lgv2018/Power-Supply/README.md

# Power-Supply
Power supply based on arduino
test on my laptop
