lgv2018/Power-Supply/schematic/PowerSupply-Om.xlsx

Sheet: Sheet1
Specifications
Max voltage [v] | 20.48
Current (Max) [A] | 2.048
Resistor (Sense) | 0.1
# of resistors | 1
Eq. resistance [Ω] | 0.10
Voltage drop [V] | 0.2048
OpAmp Gain | 10
Final volt | 2.048
power of resistor [w] | 0.042 |  |  |  |  | 741 | 24.1
Measurement |  | Op-Amp Offset (max) |  | 32768 | 256 |  | 11856
ADC bit | 15 | mV | uV
ADC Type | MCP3427 | 0.062 | 62.500 |  |  |  |  | 741 | 241 | 24.1
Vref | 2.048
Current measurement
current resolution [A]/bit | 6.25e-05
current resolution/bit [mA] | 0.062
Voltage measurement
Voltage resolution [v]/bit | 0.001
Voltage resolution/bit [mv] | 0.625
Control |  | Op-Amp Offset (max)
DAC bit | 12 | mV | uV
DAC Type | MCP4726 | 0.500 | 500.000
Vref (Internal) | 2.048
Vout/bit [mv] | 0.5
Current command
Set current resolution [mA]/bit | 0.5
Voltage command
Set voltage resolution [mv]/bit | 5

Sheet: Combined
Final qty | Value | Package | Device | Parts | Description | Source
2 | 6V/0.5A | 1206 | PPTC_HALF-AMP | F2 | Resettable Fuse PPTC | Available
11 |  | 1X02 | PINHD-1X2 | JP51, JP62 | PIN HEADER | Available
2 |  | 1X05 | PINHD-1X5 | ICSP | PIN HEADER | Available
2 |  | 1X06 | PINHD-1X6 | JTAG | PIN HEADER | Available
2 |  | 1X17 | PINHD-1X17 | JP1, JP2 | PIN HEADER | Available
2 |  | 1X20 | PINHD-1X20 | JP1, JP2 | PIN HEADER | Available
2 |  | 2X04 | PINHD-2X4 | JP2, JP3 | PIN HEADER | Available
1 |  | 2X05 | PINHD-2X5 | JP1 | PIN HEADER | Available
1 | 93LC46 | 93LC46 | SOIC8 | IC2 |  | LCSC
2 | AUDIO_JACK_TRRSSMD_RA | AUDIO_JACK_3.5MM_TRRS_SMD_RA | AUDIO_JACK_TRRSSMD_RA | AUDIO | Audio Jack - 3.5mm TRRS (SMD) | LCSC
129 | 100nf | C0603 | C-EUC0603 | C1, C2, C3, C5, C8, C9, C12, C13, C14, C16, C18, C19, C21, C23, C24, C28, C29, C30, C34, C36, C37, C38, C39, C44, C45, C46, C47, C48, C52, C57, C58, C59, C60, C61, C62, C63, C64, C65, C66, C68, C71, C74, C76, C79, C84, C86, C90, C91 | CAPACITOR, European symbol | LCSC
6 | 22pf | C0603 | CAPC603 | C12, C13 |  | LCSC | To
61 | 100nf | C0805 | C-EUC0805 | C4, C22 | CAPACITOR, European symbol | LCSC
50 | 100pf | C0805 | C-EUC0805 | C41, C42, C43, C44, C45, C46, C47, C48, C49, C50 | CAPACITOR, European symbol | LCSC
51 | 10nf | C0805 | C-EUC0805 | C21, C22, C23, C24, C25, C26, C27, C28, C29, C30 | CAPACITOR, European symbol | LCSC
4 | 10pf | C0805 | C-EUC0805 | C69, C70 | CAPACITOR, European symbol | Available
2 | 10uf | C0805 | C-EUC0805 | C67 | CAPACITOR, European symbol | LCSC
2 | 15nf | C0805 | C-EUC0805 | C17 | CAPACITOR, European symbol | LCSC
57 | 1nf | C0805 | C-EUC0805 | C31, C32, C33, C34, C35, C36, C37, C38, C39, C40 | CAPACITOR, European symbol | LCSC
12 | 2.2uf | C0805 | C-EUC0805 | C10, C11, C77, C78 | CAPACITOR, European symbol | LCSC
2 | 2.7n | C0805 | C-EUC0805 | C43 | CAPACITOR, European symbol | LCSC
4 | 22pf | C0805 | C-EUC0805 | C55, C56 | CAPACITOR, European symbol | Available
16 | 4.7n | C0805 | C-EUC0805 | C6, C7, C25, C41, C42, C49, C50, C51 | CAPACITOR, European symbol | Available
2 | 4.7uf | C0805 | C-USC0805 | C16, C17 | CAPACITOR, American symbol | LCSC
1 | 470pf | C0805 | C-USC0805 | C7 | CAPACITOR, American symbol | Available
50 | 1uf | C1206 | C-EUC1206 | C1, C2, C3, C4, C5, C6, C7, C8, C9, C10 | CAPACITOR, European symbol | LCSC
4 | 3.3uf | C1206 | C-EUC1206 | C88, C89 | CAPACITOR, European symbol | LCSC
6 | 10uf | C1210 | C-EUC1210 | C83, C85, C87 | CAPACITOR, European symbol | Available
3 | 1uF | C603 | CAPC603 | C7, C8, C9 |  | LCSC
3 | 4.7uF | CAP_POLSMC_A | SMC_A | C11, C12, C22 |  | LCSC
27 | Green | CHIP-LED0805 | LEDCHIP-LED0805 | STAT | LED | Available
4 | CON-USB-MINI-BUSB1 | CONN_USB_MINI-B | CON-USB-MINI-BUSB1 | J1 | USB connector | LCSC
2 | 32.768kHz | CRYSTAL-PTH-2X6-CYL | CRYSTAL-32.768KHZPTH-2X6 | Y3 | 32.768kHz Crystal | Available
2 | 25Mhz | CRYSTAL-SMD-3.2X2.5MM | CRYSTALSMD-3.2X2.5 | Y2 | Crystals (Generic) | Available
1 | 5MHz | CRYSTAL-SMD-5X3.2-4PAD | CRYSTALSMD-5X3.2-4PAD | Y1 | Crystals (Generic) | LCSC
2 | 47uf 25V | CT6032 | CPOL-EUCT6032 | C32 | POLARIZED CAPACITOR, European symbol | Available
6 | 1k | CTS742C083 | CTS742C083 | RN1, RN2, RN3, RN4, RN5, RN6 | Chip Resistor Array 4 Single Resistor | LCSC
2 | SMAJ13A | DO214AC | SMAJ13ASMA403A | D2 | DIODE | LCSC
2 | LM317MABDT | DPACK | LM317MABDT | IC2 | 500 mA Adjustable Output Positive Voltage Regulator | LCSC
8 | 10uf 16V | E2-5 | CPOL-EUE2-5 | C15, C20, C31 | POLARIZED CAPACITOR, European symbol | Available
10 | 47uf 16V | E2-5 | CPOL-EUE2-5 | C53, C54, C80, C81, C82 | POLARIZED CAPACITOR, European symbol | Available
6 | 47uf 25V | E2-5 | CPOL-EUE2-5 | C33, C35, C40 | POLARIZED CAPACITOR, European symbol | Available
2 | 220uf 25v | E3,5-8 | CPOL-EUE3.5-8 | C26 | POLARIZED CAPACITOR, European symbol | Available
2 | 22uf 25v | E3,5-8 | CPOL-EUE3.5-8 | C27 | POLARIZED CAPACITOR, European symbol | Available
4 | EL357 | EL357 | EL357 | U$4, U$27 |  | LCSC
2 |  | FERRITE_BEAD603 | FB603 | L1, L2 |  | Available
1 | FT2232H | FT2232H | LQFP64 | IC1 | DUAL HIGH SPEED USB TO MULTIPURPOSE UART/FIFO IC | Arrow
2 | 2A | FUSE | FUSE | F1 | FUSE | Available
3 | 12MHz | HC49/S | CRYSTALHC49S | Q1 | CRYSTAL | LCSC
1 | 10mH | INDUCTOR_L0805 | INDUCTOR/FERRITE-BEAD0805 | L1 |  | Available
1 | 1mH | INDUCTOR_L0805 | INDUCTOR/FERRITE-BEAD0805 | L2 |  | Available
1 |  | JP1EJP | 1X02 | JP4 | JUMPER | Available
350 |  | JP2 | JP2 | JP52, JP53, JP54, JP55, JP56, JP57, JP58, JP59, JP60, JP61, JP63, JP64, JP65, JP66, JP67, JP68, JP69, JP70, JP71, JP72, JP73, JP74, JP75, JP76, JP77, JP78, JP79, JP80, JP81, JP82, JP83, JP84, JP85, JP86, JP87, JP88, JP89, JP90, JP91, JP92, JP93, JP94, JP95, JP96, JP97, JP98, JP99, JP100, JP101, JP102, JP103, JP104, JP105, JP106, JP107, JP108, JP109, JP110, JP111, JP112, JP113, JP114, JP115, JP116, JP117, JP118, JP119, JP120, JP121, JP122 | JUMPER | Available
255 |  | JP2@1 | JP2E | JP1, JP2, JP3, JP4, JP5, JP6, JP7, JP8, JP9, JP10, JP11, JP12, JP13, JP14, JP15, JP16, JP17, JP18, JP19, JP20, JP21, JP22, JP23, JP24, JP25, JP26, JP27, JP28, JP29, JP30, JP31, JP32, JP33, JP34, JP35, JP36, JP37, JP38, JP39, JP40, JP41, JP42, JP43, JP44, JP45, JP46, JP47, JP48, JP49, JP50, JP123 | JUMPER | Available
1 | LD1117-3.3 | LD1117-3.3 | SOT223 | IC3 |  | Available
2 | STM32F427VIT6 | LQFP100 | STM32F427VIT6 | U$28 | STM32F405RGT6 | Available
1 | TMS320F28027PTTHCTSMD | LQFP-48 | TMS320F28027PTTHCTSMD | IC3 |  | Available
2 | MICROSD-9P | MICRO-SD9+4P-SMD-16.1X14.5X1.85MM | MICRO-SD-CARD-HOLDER-9P | J3 | 320090008 | LCSC
10 | MKDSN1,5/2-5,08 | MKDSN1,5/2-5,08 | MKDSN1,5/2-5,08 | X1, X3 | MKDSN 1,5/ 2-5,08 Printklemme | Available
1 | OSC-OSCILLATOR | OSCILLATOR_7X5_SMD | OSC-OSCILLATOR | Q1 | Oscillator | Available
1 | P8X32A | P8X32A-Q44_MCU | P8X32A-Q44 | U1 | Propellor uC | Arrow
1 |  | PINHD-1X6 | 1X06 | JP1 | PIN HEADER | Available
1 |  | PINHD-1X9 | 1X09 | JP2 | PIN HEADER | Available
1 |  | PINHEAD_-_COPY_PINHD-2X10SHROUDED | PINHEAD_-_COPY_PINSHRD_PTH_2X10 | JTAG | PIN HEADER | Available
1 | HEADER2X5-SHRD-PTH-B | PINSHRD_PTH_2X05B | HEADER2X5-SHRD-PTH-B | IO | Shrouded pin header, 2.54mm pitch | Available
2 | POWER_JACK | POWER_JACK_PTH | POWER_JACK | J2 | Power Jack Connector | Available
2 | MCP23008QFN20 | QFN20 | MCP23008QFN20 | IC16 | MCP23008 | Arrow
2 | 0R | R0402 | R-EU_R0402 | R76 | RESISTOR, European symbol | Available
4 | 1.8k 0.1% | R0603 | R-US_R0603 | R29, R31 | RESISTOR, American symbol | LCSC
10 | 0R | R0805 | R-US_R0805 | R17, R30, R45, R46, R70 | RESISTOR, American symbol | Available
2 | 1.5k | R0805 | R-US_R0805 | R63 | RESISTOR, American symbol | Available
48 | 100k | R0805 | R-US_R0805 | R62 | RESISTOR, American symbol | LCSC
4 | 100R | R0805 | R-US_R0805 | R18, R19 | RESISTOR, American symbol | Available
89 | 10k | R0805 | R-US_R0805 | R11, R49, R51, R52, R53, R54, R56, R60, R61, R67, R68, R69, R71, R72, R73, R75, R78, R82, R83 | RESISTOR, American symbol | LCSC
4 | 10R | R0805 | R-US_R0805 | R22, R23 | RESISTOR, American symbol | Available
1 | 18k | R0805 | R-US_R0805 | R9 | RESISTOR, American symbol | Available
6 | 18k 0.1% | R0805 | R-US_R0805 | R13, R26, R28 | RESISTOR, American symbol | Available
20 | 1k | R0805 | R-US_R0805 | R39, R42, R43, R65 | RESISTOR, American symbol | Available
4 | 1k 0.1% | R0805 | R-US_R0805 | R14, R86 | RESISTOR, American symbol | Available
45 | 1M | R0805 | R-US_R0805 | R1, R2, R3, R4, R5, R6, R7, R8, R9 | RESISTOR, American symbol | LCSC
16 | 2.2k | R0805 | R-US_R0805 | R2, R5, R9, R21, R24, R32, R37 | RESISTOR, American symbol | Available
2 | 20k | R0805 | R-US_R0805 | R74 | RESISTOR, American symbol | Available
6 | 20R | R0805 | R-US_R0805 | R57, R58, R79 | RESISTOR, American symbol | Available
6 | 220R | R0805 | R-US_R0805 | R20, R25, R33 | RESISTOR, American symbol | Available
2 | 240R | R0805 | R-US_R0805 | R15 | RESISTOR, American symbol | Available
8 | 250R | R0805 | R-US_R0805 | R47, R59, R84, R85 | RESISTOR, American symbol | Available
1 | 270R | R0805 | R-US_R0805 | R5 | RESISTOR, American symbol | Available
7 | 2K | R0805 | R-US_R0805 | R1, R5 | RESISTOR, American symbol | Available
2 | 330R | R0805 | R-US_R0805 | R10 | RESISTOR, American symbol | Available
2 | 400R | R0805 | R-US_R0805 | R41 | RESISTOR, American symbol | Available
7 | 470R | R0805 | R-US_R0805 | R4, R80, R81 | RESISTOR, American symbol | Available
6 | 500R | R0805 | R-US_R0805 | R55 | RESISTOR, American symbol | Available
4 | 50R | R0805 | R-US_R0805 | R16, R44 | RESISTOR, American symbol | Available
1 | 5k | R0805 | R-US_R0805 | R2 | RESISTOR, American symbol | Available
18 | 6.8k | R0805 | R-US_R0805 | R3, R6, R7, R8, R35, R36, R40, R64, R66 | RESISTOR, American symbol | Available
4 | 680R | R0805 | R-US_R0805 | R1, R27 | RESISTOR, American symbol | Available
1 | 8.2k | R0805 | R-US_R0805 | R10 | RESISTOR, American symbol | Available
2 | 9k | R0805 | R-US_R0805 | R38 | RESISTOR, American symbol | LCSC
2 | NC | R0805 | R-US_R0805 | R34 | RESISTOR, American symbol | Available
45 | 1R | R1206 | R-US_R1206 | R55, R56, R57, R58, R59, R60, R61, R62, R63 | RESISTOR, American symbol | LCSC
45 | 100R | R1210 | R-US_R1210 | R37, R38, R39, R40, R41, R42, R43, R44, R45 | RESISTOR, American symbol | LCSC
45 | 10R | R1210 | R-US_R1210 | R46, R47, R48, R49, R50, R51, R52, R53, R54 | RESISTOR, American symbol | LCSC
45 | 1k | R1210 | R-US_R1210 | R28, R29, R30, R31, R32, R33, R34, R35, R36 | RESISTOR, American symbol | LCSC
2 | 0R100 | R2512 | R-EU_R2512 | R12 | RESISTOR, European symbol | Available
1 | 100R | RESISTORR1206 | R1206 | R8 |  | Available
4 | 10k | RN8P-4R-CRA06S | RNETWORK | RN1, RN2, RN3 | 4 Resistor Array 0603 | Available
1 | 12K | R-US_R0805 | R0805 | R1 | RESISTOR, American symbol | Available
9 | 82R | R-US_R0805 | R0805 | R3, R4, R5, R7, R9, R13, R14, R15, R16 | RESISTOR, American symbol | Available
2 | S1M | SMA | S1M | D1 |  | Available
4 | 10uF | SMC_A | CPOL-EUSMCA | C10, C11 | POLARIZED CAPACITOR, European symbol | LCSC
5 | 3.3uF | SMC_A | CAP_POLSMC_A | C5, C6, C7, C9 |  | LCSC
2 | CH340G | SO016 | CH340GSMD | U1 | A simple USB 2.0 to Serial IC. | Available
1 | 24LC256 | SO08 | EEPROM-I2CSMD | U2 | I2C EEPROMs, 24LC256 and others | LCSC
4 | LM358D | SO08 | LM358D | IC14, IC19 | OP AMP also LM158; LM258; LM2904 | Available
2 | OPA2196 | SO08 | LM358D | IC1 | OP AMP also LM158; LM258; LM2904 | Available
4 | OPA2197 | SO08 | LM358D | IC3 | OP AMP also LM158; LM258; LM2904 | Available
2 | W25Q32 | SO08 | SPI_FLASH-X25XXSMD | U1 | 32M Serial Flash Memory | LCSC
2 | ISO1541D | SO-08 | ISO1541D | IC11 |  | Available
2 | MCP1501-20E/SN | SO-08 | MCP1501-20E/SN | IC5 |  | Available
4 | 744053S | SO16 | 744053S | IC12, IC13 | Triple 2-channel analog multiplexer/demultiplexer | LCSC
1 | AD8655R | SO8 | AD8655R | IC2 | Low Noise, Precision CMOS Amplifier | Arrow
3 | REG1117 | SOT223 | REG1117 | IC18 | 800mA and 1A Low Dropout (LDO) Positive Regulator | Available
2 | V_REG_317SMD | SOT223 | V_REG_317SMD | IC8 | Voltage Regulator | LCSC
2 | 2N7002 | SOT23 | MOSFET-NCHANNELBSS138 | Q2 | Common NMOSFET Parts | LCSC
8 | BAS40-04 | SOT23 | BAS40-04 | D3, D4, D7, D8 | Silicon Schottky Diodes | LCSC
2 | BC847 | SOT23 | BC847 | T2 | NPN TRANSISTOR | LCSC
5 | FDN340P | SOT-23 | SMD-MOSFET-P-CH-20V-2A-FDN340P(SOT-23) | Q3 | 305030026 | LCSC
1 | AP2204K-3.3TRG1 | SOT-23-5 | AP2204K-3.3TRG1 | U3 | 150ma Low-Noise LDO Regulator | LCSC
2 | ME6206A33P1G | SOT-23-5 | MIC5205 | VR1, VR2 | 150ma Low-Noise LDO Regulator | LCSC
1 | NCP114ASN180T1G | SOT-23-5 | NCP114ASN180T1G | U2 | 150ma Low-Noise LDO Regulator | LCSC
1 | TJ5205SF5-5.0 | SOT-23-5 | MIC5205 | VR3 | 150ma Low-Noise LDO Regulator | LCSC
4 | MCP4726 | SOT23-6 | MCP4726 | IC6, IC7 |  | Available
2 | USBLC6-2P | SOT23-6 | USBLC6-2P | D5 |  | LCSC
4 | MMBT2222A | SOT23-BEC | MMBT2222ALT1-NPN-SOT23-BEC | T3, T4 | NPN Transistror | Available
1 | MMBT3904 | SOT23-BEC | MMBT3904LT1-NPN-SOT23-BEC | T1 | NPN Transistror | Available
2 | PMBT3906 | SOT23-BEC | MMBT3906LT1-PNP-SOT23-BEC | T1 | PNP Transistror | Available
1 | ME6206A33P1G | SOT89 | ME6206A33P1G | IC1 |  | LCSC
4 | L79L05SOT89 | SOT89 | L79L05SOT89 | U$22, U$24 |  | LCSC
1 | PIC24FJ64GA002 | SSOP28 | PIC24FJ64GA002 | IC1 | 16-bit General Purpose Flash Microcontroller | Arrow
1 |  | SW-SMD-SMALL | TACT_SWITCH_SMALL | PB |  | Available
1 | SMD button small | TACT_SWITCH_SMALL | SMD_TACT_SMALL | PB |  | Available
7 | SWITCH-SWITCH-SMD-3.0X4.0X2.0MM | TACTILE_SWITCH_SMD_6.0X3.5MM | SWITCH-SWITCH-SMD-3.0X4.0X2.0MM | K15, RST, WK_UP |  | Available
1 | MOMENTARY-SWITCH-SPST-SMD-6.2MM-TALL | TACTILE_SWITCH_SMD_6.2MM_TALL | MOMENTARY-SWITCH-SPST-SMD-6.2MM-TALL | S1 | Momentary Switch (Pushbutton) - SPST | Available
2 | TIP147 | TO220AV | TIP42C | Q4 | PNP TRANSISTOR | LCSC
2 | 7805DT | TO252 | 7805DT | IC17 | Positive VOLTAGE REGULATOR | LCSC
2 | MCP9700 | TO92-BCE | MCP9700 | U$20 |  | Available
2 | CS4344 | TSSOP10 | CS4344 | U$29 |  | LCSC
1 | 4066 | TSSOP14 | 4066 | IC3 | Quad bilateral ANALOG SWITCH | LCSC
2 | MCP3428TSSOP | TSSOP14 | MCP3428TSSOP | IC15 |  | Available
3 | TXS0108 | TSSOP20-0.65-6.5X4.4MM | LOGIC-TXS0108EPWR(TSSOP20) | U3, U4, U5 | 310050026 | LCSC
2 | USB-FS | USB-MINIB | USBMINIB | USB | USB Connectors | LCSC
1 | 700mA+ ferrite | WE-KI_0805_B | WE-KIL_0805 | L1 | SMD Wire Wound Ceramic Inductor WE-KIL | Available
6 | SRV05-4-N | WE-TVS_SOT23-6L | WE-TVS_SOT23-6L_HS_824015 | D1, D2, D3, D4, D5, D6 | WE-TVS TVS Diode – High Speed Series | LCSC
2 | XC2C32A_VQ44_2 | XC2C32A_VQ44_2 | VQ44 | IC4 | xc2c32a_vq44-ian edit this description | Aliexpress
1 | 3.6V Zener | ZENERSOD-123 | SOD-123 | D1 | Zener Diode SOD-323 | LCSC

Sheet: Sheet9
LCSC Part Number | Manufacture Part Number | Manufacturer | Package | Description | RoHS | Order Qty. | Min\Mult Order Qty. | Unit Price | Order Price | Product Link
C282732 | TCC0805X7R104K500DT | CCTC | 0805 | Multilayer Ceramic Capacitors MLCC - SMD/SMT 100nF 50V 0805 RoHS | yes | 500 | 50\50 | 0.0037 | 1.85 | https://lcsc.com/product-detail/Multilayer-Ceramic-Capacitors-MLCC-SMD-SMT_CCTC-TCC0805X7R104K500DT_C282732.html
C307531 | CL21A226MQQNNNF | Samsung Electro-Mechanics | 0805 | Multilayer Ceramic Capacitors MLCC - SMD/SMT 22uF 6.3V 0805 RoHS | yes | 20 | 20\20 | 0.0219 | 0.438 | https://lcsc.com/product-detail/Others_Samsung-Electro-Mechanics_CL21A226MQQNNNF_Samsung-Electro-Mechanics-CL21A226MQQNNNF_C307531.html
C15850 | CL21A106KAYNNNE | Samsung Electro-Mechanics | 0805 | Multilayer Ceramic Capacitors MLCC - SMD/SMT 10uF 25V 0805 RoHS | yes | 40 | 20\20 | 0.0188 | 0.752 | https://lcsc.com/product-detail/Multilayer-Ceramic-Capacitors-MLCC-SMD-SMT_SAMSUNG_CL21A106KAYNNNE_10uF-106-10-25V_C15850.html
C49217 | 0805F225M500NT | Guangdong Fenghua Advanced Tech | 0805 | Multilayer Ceramic Capacitors MLCC - SMD/SMT 2.2uF 50V 0805 RoHS | yes | 20 | 20\20 | 0.0318 | 0.636 | https://lcsc.com/product-detail/Multilayer-Ceramic-Capacitors-MLCC-SMD-SMT_2-2uF-225-20-50V_C49217.html
C108453 | MM1Z3B3 | Semtech | SOD-123 | Zener Diodes SOD-123 RoHS | yes | 20 | 20\20 | 0.0168 | 0.336 | https://lcsc.com/product-detail/Zener-Diodes_MM1Z3B3_C108453.html
C113174 | MM1Z4B7 | Semtech | SOD-123 | Zener Diodes SOD-123 RoHS | yes | 20 | 20\20 | 0.016 | 0.32 | https://lcsc.com/product-detail/Zener-Diodes_MM1Z4B7_C113174.html
C118717 | MM1Z5248B | Semtech | SOD-123 | Zener Diodes SOD-123 RoHS | yes | 20 | 20\20 | 0.0223 | 0.446 | https://lcsc.com/product-detail/Zener-Diodes_MM1Z5248B_C118717.html
C309876 | SMAJ22CA | Brightking Elec (TAIWAN) | SMA(DO-214AC) | TVS SMA(DO-214AC) RoHS | yes | 10 | 10\10 | 0.0636 | 0.636 | https://lcsc.com/product-detail/Others_Brightking-Elec-TAIWAN-SMAJ22CA_C309876.html
C78265 | BAS40-04LT1G | ON Semicon | SOT-23(SOT-23-3) | Schottky Barrier Diodes (SBD) SOT-23(SOT-23-3) RoHS | yes | 20 | 20\20 | 0.0293 | 0.586 | https://lcsc.com/product-detail/Schottky-Barrier-Diodes-SBD_ON-Semicon_BAS40-04LT1G_ON-Semicon-ON-BAS40-04LT1G_C78265.html
C85047 | 2N7002K-7 | Diodes Incorporated | SOT-23(SOT-23-3) | MOSFET N Trench 60V 380mA 2.5V @ 1mA 2 Ω @ 500mA，10V SOT-23(SOT-23-3) RoHS | yes | 20 | 20\20 | 0.0276 | 0.552 | https://lcsc.com/product-detail/MOSFET_Diodes-Incorporated_2N7002K-7_Diodes-Incorporated-2N7002K-7_C85047.html
C5647 | 74HC4053D,653 | Nexperia | SOIC-16_150mil | 74 Series SOIC-16_150mil RoHS | yes | 5 | 1\1 | 0.1559 | 0.7795 | https://lcsc.com/product-detail/74-Series_NXP_74HC4053D_74HC4053D_C5647.html
C19651 | LM317G-AA3-R | Unisonic Tech | SOT-223 | Linear Voltage Regulators SOT-223 RoHS | yes | 5 | 5\5 | 0.1056 | 0.528 | https://lcsc.com/product-detail/Linear-Voltage-Regulators_LM317G-AA3-R_C19651.html
C384446 | WF12P1R00FTL | Walsin Tech Corp | 1206 | Chip Resistor - Surface Mount 1Ohms ±1% 1/2W 1206 RoHS | yes | 50 | 50\50 | 0.0085 | 0.425 | https://lcsc.com/product-detail/New-Arrivals_Walsin-Tech-Corp-WF12P1R00FTL_C384446.html
C83141 | RC1210FR-0710RL | YAGEO | 1210 | Chip Resistor - Surface Mount 10Ohms ±1% 1/2W 1210 RoHS | yes | 50 | 20\20 | 0.0175 | 0.875 | https://lcsc.com/product-detail/Chip-Resistor-Surface-Mount_10R-10R0-1_C83141.html
C104955 | RTT121000FTP | RALEC | 1210 | Chip Resistor - Surface Mount 100Ohms ±1% 1/2W 1210 RoHS | yes | 50 | 50\50 | 0.0098 | 0.49 | https://lcsc.com/product-detail/Chip-Resistor-Surface-Mount_100R-1000-1_C104955.html
C104956 | RTT121001FTP | RALEC | 1210 | Chip Resistor - Surface Mount 1KOhms ±1% 1/2W 1210 RoHS | yes | 50 | 50\50 | 0.0094 | 0.47 | https://lcsc.com/product-detail/Chip-Resistor-Surface-Mount_1KR-1001-1_C104956.html
C276216 | RK73H2ATTD1003F | KOA Speer Elec | 0805 | Chip Resistor - Surface Mount 100KOhms ±1% 1/4W 0805 RoHS | yes | 100 | 50\50 | 0.0046 | 0.46 | https://lcsc.com/product-detail/Others_KOA-Speer-Elec-RK73H2ATTD1003F_C276216.html
C116837 | 0805B104J101 | Walsin Tech Corp | 0805 | Multilayer Ceramic Capacitors MLCC - SMD/SMT 100nF 100V 0805 RoHS | yes | 60 | 20\20 | 0.0203 | 1.218 | https://lcsc.com/product-detail/Multilayer-Ceramic-Capacitors-MLCC-SMD-SMT_100nF-104-5-100V_C116837.html
C77483 | 0805N102J101 | Walsin Tech Corp | 0805 | Multilayer Ceramic Capacitors MLCC - SMD/SMT 1nF 100V 0805 RoHS | yes | 50 | 50\50 | 0.0111 | 0.555 | https://lcsc.com/product-detail/High-Voltage-Capacitors_1nF-102-5-100V_C77483.html
C296072 | 0805B103J101CT | Walsin Tech Corp | 0805 | Multilayer Ceramic Capacitors MLCC - SMD/SMT 10nF 100V 0805 RoHS | yes | 60 | 20\20 | 0.0191 | 1.146 | https://lcsc.com/product-detail/Others_Huaxin-S-T-0805B103J101CT_C296072.html
C7519 | USBLC6-2SC6 | STMicroelectronics | SOT-23-6 | Diodes - ESD SOT-23-6 RoHS | yes | 5 | 5\5 | 0.0883 | 0.4415 | https://lcsc.com/product-detail/Diodes-ESD_STMicroelectronics_USBLC6-2SC6_USBLC6-2SC6_C7519.html
C82344 | W25Q32JVSSIQ | Winbond Elec | SOIC-8_208mil | FLASH FLASH 32Mb (4M x 8) SPI - Dual/Quad I/O SOIC-8_208mil RoHS | yes | 3 | 1\1 | 0.2641 | 0.7923 | https://lcsc.com/product-detail/FLASH_Winbond-Elec-W25Q32JVSSIQ_C82344.html
C8952 | CS4344-CZZR | Cirrus Logic | TSSOP-10 | Digital To Analog Converters (DACs) 24 I2S 3.3 V,5 V TSSOP-10 RoHS | yes | 1 | 1\1 | 0.5027 | 0.5027 | https://lcsc.com/product-detail/Digital-To-Analog-Converters-DACs_Cirrus-Logic_CS4344-CZZ_CS4344-CZZ_C8952.html
C91145 | TF-01A | Korean Hroparts Elec | SMD | Connector - Card Sockets 8 1.1mm SMD RoHS | yes | 1 | 1\1 | 0.1973 | 0.1973 | https://lcsc.com/product-detail/Connector-Card-Sockets_Korean-Hroparts-Elec-TF-01A_C91145.html
C231644 | KAN0444-0201B/102 | GANGYUAN | SMD | Tactile Switches SPST-NO 4.00mm x 3.00mm 2.00mm 50mA @ 12VDC SMD RoHS | yes | 5 | 5\5 | 0.07 | 0.35 | https://lcsc.com/product-detail/Others_GANGYUAN-KAN0444-0201B-102_C231644.html
C319111 | PJ-320D-X | XKB Enterprise | SMD | Audio & Video Connectors Female SMD RoHS | yes | 1 | 1\1 | 0.1416 | 0.1416 | https://lcsc.com/product-detail/Audio-Video-Connectors_XKB-Enterprise-PJ-320D-X_C319111.html
C59782 | CL10B105KO8NNNC | Samsung Electro-Mechanics | 0603 | Multilayer Ceramic Capacitors MLCC - SMD/SMT 1uF 16V 0603 RoHS | yes | 50 | 50\50 | 0.0065 | 0.325 | https://lcsc.com/product-detail/Multilayer-Ceramic-Capacitors-MLCC-SMD-SMT_SAMSUNG_CL10B105KO8NNNC_1uF-105-10-16V_C59782.html
C75560 | PMV48XP,215 | Nexperia | SOT-23(SOT-23-3) | MOSFET P Trench 20V 3.5A 1.25V @ 250uA 55 mΩ @ 2.4A，4.5V SOT-23(SOT-23-3) RoHS | yes | 5 | 5\5 | 0.0865 | 0.4325 | https://lcsc.com/product-detail/MOSFET_Nexperia_PMV48XP-215_Nexperia-PMV48XP-215_C75560.html
C180952 | RU20P3B | Shenzhen ruichips Semicon | SOT-23(SOT-23-3) | MOSFET P Trench 20V 3A 1V @ 250uA 100 mΩ @ 3A，4.5V SOT-23(SOT-23-3) RoHS | yes | 20 | 20\20 | 0.0202 | 0.404 | https://lcsc.com/product-detail/MOSFET_Shenzhen-ruichips-Semicon-RU20P3B_C180952.html
C268590 | MMSZ5231A | PANJIT International | SOD-123 | Zener Diodes SOD-123 RoHS | yes | 20 | 20\20 | 0.0167 | 0.334 | https://lcsc.com/product-detail/New-Arrivals_PANJIT-International-MMSZ5231A_C268590.html
C282320 | MMSZ5251B_R1_00001 | PANJIT International | SOD-123 | Zener Diodes SOD-123 RoHS | yes | 20 | 20\20 | 0.0184 | 0.368 | https://lcsc.com/product-detail/Others_PANJIT-International-MMSZ5251B-R1-00001_C282320.html
C131846 | LBZT52C16T1G | Leshan Radio | SOD-123 | Zener Diodes SOD-123 RoHS | yes | 20 | 20\20 | 0.0184 | 0.368 | https://lcsc.com/product-detail/Zener-Diodes_LBZT52C16T1G_C131846.html
C2109 | BZT52C24 | Changjiang Electronics Tech (CJ) | SOD-123 | Zener Diodes SOD-123 RoHS | yes | 20 | 20\20 | 0.0185 | 0.37 | https://lcsc.com/product-detail/Zener-Diodes_Changjiang-Electronics-Tech-CJ-BZT52C24_C2109.html
C150094 | BC847CLT1G | ON Semicon | SOT-23(SOT-23-3) | Transistors (NPN/PNP) NPN 100mA 45V SOT-23(SOT-23-3) RoHS | yes | 20 | 20\20 | 0.0162 | 0.324 | https://lcsc.com/product-detail/Transistors-NPN-PNP_ON-Semicon_BC847CLT1G_ON-Semicon-ON-BC847CLT1G_C150094.html
C6649 | EL357N(B)(TA)-G | Everlight Elec | SOP-4_P2.54 | DIP Optocouplers SOP-4_P2.54 RoHS | yes | 5 | 5\5 | 0.0617 | 0.3085 | https://lcsc.com/product-detail/SMD-Optocouplers_EL357N-B-TA-G_C6649.html
C84047 | TIP147 | STMicroelectronics | TO-247 | Darlington Transistors 10A 100V TO-247 RoHS | yes | 2 | 1\1 | 0.9514 | 1.9028 | https://lcsc.com/product-detail/Others_STMicroelectronics_TIP147_STMicroelectronics-TIP147_C84047.html
C183890 | 78M12 | Guangdong Hottech | TO-252-2(DPAK) | Linear Voltage Regulators TO-252-2(DPAK) RoHS | yes | 5 | 5\5 | 0.0721 | 0.3605 | https://lcsc.com/product-detail/Linear-Voltage-Regulators_78M12_C183890.html
C5422 | CL21F105ZBFNNNE | Samsung Electro-Mechanics | 0805 | Multilayer Ceramic Capacitors MLCC - SMD/SMT 1uF 50V 0805 RoHS | yes | 50 | 50\50 | 0.013 | 0.65 | https://lcsc.com/product-detail/Multilayer-Ceramic-Capacitors-MLCC-SMD-SMT_SAMSUNG_CL21F105ZBFNNNE_1uF-105-80-20-50V_C5422.html
C296080 | 0805X335K250CT | Walsin Tech Corp | 0805 | Multilayer Ceramic Capacitors MLCC - SMD/SMT 3.3uF 25V 0805 RoHS | yes | 10 | 10\10 | 0.035 | 0.35 | https://lcsc.com/product-detail/Others_Huaxin-S-T-0805X335K250CT_C296080.html
C282825 | TCC1206X7R105M101HT | CCTC | 1206 | Multilayer Ceramic Capacitors MLCC - SMD/SMT 1uF 100V 1206 RoHS | yes | 60 | 20\20 | 0.028 | 1.68 | https://lcsc.com/product-detail/Multilayer-Ceramic-Capacitors-MLCC-SMD-SMT_CCTC-TCC1206X7R105M101HT_C282825.html
C107105 | CC0805JRNPO0BN101 | YAGEO | 0805 | Multilayer Ceramic Capacitors MLCC - SMD/SMT 100pF 100V 0805 RoHS | yes | 50 | 50\50 | 0.0093 | 0.465 | https://lcsc.com/product-detail/Multilayer-Ceramic-Capacitors-MLCC-SMD-SMT_100pF-101-5-100V_C107105.html
C228604 | AC0805FR-071ML | YAGEO | 0805 | Chip Resistor - Surface Mount 1MOhms ±1% 1/8W 0805 RoHS | yes | 50 | 100\100 | 0.0028 | 0.14 | https://lcsc.com/product-detail/Others_YAGEO-AC0805FR-071ML_C228604.html
C113194 | RM10FTN1002 | TA-I Tech | 0805 | Chip Resistor - Surface Mount 10KOhms ±1% 1/8W 0805 RoHS | yes | 50 | 50\50 | 0.0035 | 0.175 | https://lcsc.com/product-detail/Chip-Resistor-Surface-Mount_10KR-1002-1_C113194.html
C351669 | PTFR0603B1K80P9 | ResistorToday | 0603 | High Precision & Low TCR SMD Resistors 1.8KOhms ±0.1% 1/10W 0603 RoHS | yes | 5 | 5\5 | 0.0683 | 0.3415 | https://lcsc.com/product-detail/Others_ResistorToday-PTFR0603B1K80P9_C351669.html
C122849 | 79L05 | Shikues | SOT-89(SOT-89-3) | Linear Voltage Regulators SOT-89(SOT-89-3) RoHS | yes | 10 | 10\10 | 0.0594 | 0.594 | https://lcsc.com/product-detail/Linear-Voltage-Regulators_79L05_C122849.html
C18091 | 24LC512T-I/SM | Microchip Tech | SOIC-8_208mil | EEPROM EEPROM 512Kb (64K x 8) I2C SOIC-8_208mil RoHS | yes | 1 | 1\1 | 1.0707 | 1.0707 | https://lcsc.com/product-detail/EEPROM_MICROCHIP_24lc512T-I-SM_24lc512T-I-SM_C18091.html
C17206 | TXS0108EPWR | Texas Instruments | TSSOP-20 | Level Translators, Shifters TSSOP-20 RoHS | yes | 3 | 1\1 | 0.7191 | 2.1573 | https://lcsc.com/product-detail/Interface-ICs_TI_TXS0108EPWR_TXS0108EPWR_C17206.html
C20197 | 4D03WGJ0102T5E | Uniroyal Elec | 0603_x4 | Resistor Networks & Arrays 1KOhms ±5% 1/16W 0603_x4 RoHS | yes | 50 | 50\50 | 0.004 | 0.2 | https://lcsc.com/product-detail/Resistor-Networks-Arrays_Uniroyal-Elec-4D03WGJ0102T5E_C20197.html
C69074 | - | Jing Extension of the Electronic Co. | SMD | USB Connectors 5 Receptacle 1 SMD RoHS | yes | 10 | 10\10 | 0.0619 | 0.619 | https://lcsc.com/product-detail/USB-Connectors_Jing-Extension-of-the-Electronic-Co-LCSC-MINI-5PMotherboard-Copper-shell-with-column-LCPVinyl-High-temperature_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
C2198 | X49SD5MSD2SC | Yangxing Tech | HC-49S | 49S 5MHz ±20ppm HC-49S RoHS | yes | 5 | 5\5 | 0.0859 | 0.4295 | https://lcsc.com/product-detail/49S_Yangxing-Tech-X49SD5MSD2SC_C2198.html
C5628 | 74HC4066D,653 | Nexperia | SOIC-14_150mil | 74 Series SOIC-14_150mil RoHS | yes | 3 | 1\1 | 0.1591 | 0.4773 | https://lcsc.com/product-detail/74-Series_NXP_74HC4066D_74HC4066D_C5628.html
C126091 | TJ5205SF5-5.0 | HTC Korea TAEJIN Tech | SOT-23-5 | Low Dropout Regulators(LDO) Positive Fixed 350mV @ 150mA 16V 5V 150mA SOT-23-5 RoHS | yes | 1 | 1\1 | 0.1511 | 0.1511 | https://lcsc.com/product-detail/Low-Dropout-Regulators-LDO_HTC_TJ5205SF5-5-0_TJ5205SF5-5-0_C126091.html
C112032 | AP2204K-3.3TRG1 | Diodes Incorporated | SOT-23-5 | Low Dropout Regulators(LDO) Positive Fixed 500mV @ 150mA 24V 3.3V 200mA SOT-23-5 RoHS | yes | 2 | 1\1 | 0.1082 | 0.2164 | https://lcsc.com/product-detail/Low-Dropout-Regulators-LDO_DIODES_AP2204K-3-3TRG1_AP2204K-3-3TRG1_C112032.html
C16253 | 93LC46BT-I/SN | Microchip Tech | SOIC-8_150mil | EEPROM EEPROM 1Kb (64 x 16) SPI SOIC-8_150mil RoHS | yes | 1 | 1\1 | 0.1861 | 0.1861 | https://lcsc.com/product-detail/EEPROM_MICROCHIP_93LC46BT-I-SN_93LC46BT-I-SN_C16253.html
C127674 | HC-49S12MHz20pF30PPM | Zhejiang Abel Elec | HC-49S | 49S 12MHz ±30ppm HC-49S RoHS | yes | 5 | 5\5 | 0.0636 | 0.318 | https://lcsc.com/product-detail/49S_HC-49S-12MHz-20pF-30PPM_C127674.html
C126074 | LM79L05 | HTC Korea TAEJIN Tech | TO-92(TO-92-3) | Linear Voltage Regulators TO-92(TO-92-3) RoHS | yes | 5 | 5\5 | 0.0628 | 0.314 | https://lcsc.com/product-detail/Linear-Voltage-Regulators_HTC_LM79L05_LM79L05_C126074.html
C236700 | ME6206A33P1G | Nanjing Micro One Elec | SOT-89(SOT-89-3) | Linear Voltage Regulators SOT-89(SOT-89-3) RoHS | yes | 10 | 10\10 | 0.0582 | 0.582 | https://lcsc.com/product-detail/Others_Nanjing-Micro-One-Elec-ME6206A33P1G_C236700.html
C233362 | NCP114ASN180T1G | ON Semicon | TSOP-5 | Linear Voltage Regulators TSOP-5 RoHS | yes | 5 | 5\5 | 0.0852 | 0.426 | https://lcsc.com/product-detail/Linear-Voltage-Regulators_ON-Semicon_NCP114ASN180T1G_ON-Semicon-ON-NCP114ASN180T1G_C233362.html
C7184 | TAJA335K016RNJ | AVX | CASE-A_3216 | Tantalum Capacitors 3.3uF 16V CASE-A_3216 RoHS | yes | 5 | 5\5 | 0.0702 | 0.351 | https://lcsc.com/product-detail/Tantalum-Capacitors_AVX_TAJA335K016RNJ_3-3uF-335-10-16V_C7184.html
C376774 | TCC0603COG200J500CT | CCTC | 0603 | Multilayer Ceramic Capacitors MLCC - SMD/SMT 20pF 50V 0603 RoHS | yes | 50 | 50\50 | 0.0032 | 0.16 | https://lcsc.com/product-detail/New-Arrivals_CCTC-TCC0603COG200J500CT_C376774.html
C119052 | CA45-A010K106T | Hunan Xiangyee in S&T | CASE-A_3216 | Tantalum Capacitors 10uF 10V CASE-A_3216 RoHS | yes | 10 | 10\10 | 0.0634 | 0.634 | https://lcsc.com/product-detail/Tantalum-Capacitors_Hunan-Xiangyee-in-S-T-CA45-A010K106T_C119052.html
C106219 | CC0603ZRY5V7BB105 | YAGEO | 0603 | Multilayer Ceramic Capacitors MLCC - SMD/SMT 1uF 16V 0603 RoHS | yes | 50 | 50\50 | 0.0052 | 0.26 | https://lcsc.com/product-detail/Multilayer-Ceramic-Capacitors-MLCC-SMD-SMT_1uF-105-20-to-80-16V_C106219.html
C123256 | CA45-A016K475T | Hunan Xiangyee in S&T | CASE-A_3216 | Tantalum Capacitors 4.7uF 16V CASE-A_3216 RoHS | yes | 5 | 5\5 | 0.0627 | 0.3135 | https://lcsc.com/product-detail/Tantalum-Capacitors_Hunan-Xiangyee-in-S-T-CA45-A016K475T_C123256.html
C131753 | LMSZ5227BT1G | Leshan Radio | SOD-123 | Zener Diodes SOD-123 RoHS | yes | 20 | 20\20 | 0.017 | 0.34 | https://lcsc.com/product-detail/Zener-Diodes_LMSZ5227BT1G_C131753.html
C105478 | 1206X106K160NT | Guangdong Fenghua Advanced Tech | 1206 | Multilayer Ceramic Capacitors MLCC - SMD/SMT 10uF 16V 1206 RoHS | yes | 10 | 10\10 | 0.0354 | 0.354 | https://lcsc.com/product-detail/Multilayer-Ceramic-Capacitors-MLCC-SMD-SMT_10uF-106-10-16V_C105478.html
C42998 | 0603F104M500NT | Guangdong Fenghua Advanced Tech | 0603 | Multilayer Ceramic Capacitors MLCC - SMD/SMT 100nF 50V 0603 RoHS | yes | 200 | 100\100 | 0.0026 | 0.52 | https://lcsc.com/product-detail/Multilayer-Ceramic-Capacitors-MLCC-SMD-SMT_100nF-104-20-50V_C42998.html
C107143 | CC0805KRX7R9BB153 | YAGEO | 0805 | Multilayer Ceramic Capacitors MLCC - SMD/SMT 15nF 50V 0805 RoHS | yes | 50 | 50\50 | 0.006 | 0.3 | https://lcsc.com/product-detail/Multilayer-Ceramic-Capacitors-MLCC-SMD-SMT_15nF-153-10-50V_C107143.html
C68136 | LM317MDT-TR | STMicroelectronics | TO-252-2(DPAK) | Linear Voltage Regulators TO-252-2(DPAK) RoHS | yes | 2 | 1\1 | 0.14 | 0.28 | https://lcsc.com/product-detail/Linear-Voltage-Regulators_STMicroelectronics_LM317MDT-TR_LM317MDT-TR_C68136.html
C100114 | - | Boom Precision Elec | SIP-2 | Shunts & Jumpers 2 2.54mm Female Through Hole SIP-2 RoHS | yes | 50 | 50\50 | 0.0054 | 0.27 | https://lcsc.com/product-detail/Shunts-Jumpers_Short-hood2-54mm-Top-seal-Closed-type_C100114.html

Sheet: Power Supply + STM32
Qty | Final qty | Value | Device | Package | Parts | Description | MF | MPN | OC_FARNELL | OC_NEWARK | PROD_ID | SF_ID | SPICEPREFIX | VALUE
1 | 2 | 6V/0.5A | PPTC_HALF-AMP | 1206 | F2 | Resettable Fuse PPTC |  |  |  |  | RES-08585 |  |  | 6V/0.5A
1 | 2 | AUDIO_JACK_TRRSSMD_RA | AUDIO_JACK_TRRSSMD_RA | AUDIO_JACK_3.5MM_TRRS_SMD_RA | AUDIO | Audio Jack - 3.5mm TRRS (SMD) |  |  |  |  | CONN-10676 | PRT-12639
48 | 96 | 100nf | C-EUC0603 | C0603 | C1, C2, C3, C5, C8, C9, C12, C13, C14, C16, C18, C19, C21, C23, C24, C28, C29, C30, C34, C36, C37, C38, C39, C44, C45, C46, C47, C48, C52, C57, C58, C59, C60, C61, C62, C63, C64, C65, C66, C68, C71, C74, C76, C79, C84, C86, C90, C91 | CAPACITOR, European symbol |  |  |  |  |  |  | C
2 | 4 | 100nf | C-EUC0805 | C0805 | C4, C22 | CAPACITOR, European symbol |  |  |  |  |  |  | C
2 | 4 | 10pf | C-EUC0805 | C0805 | C69, C70 | CAPACITOR, European symbol |  |  |  |  |  |  | C
1 | 2 | 10uf | C-EUC0805 | C0805 | C67 | CAPACITOR, European symbol |  |  |  |  |  |  | C
1 | 2 | 15nf | C-EUC0805 | C0805 | C17 | CAPACITOR, European symbol |  |  |  |  |  |  | C
3 | 6 | 1uf | C-EUC0805 | C0805 | C72, C73, C75 | CAPACITOR, European symbol |  |  |  |  |  |  | C
4 | 8 | 2.2uf | C-EUC0805 | C0805 | C10, C11, C77, C78 | CAPACITOR, European symbol |  |  |  |  |  |  | C
1 | 2 | 2.7n | C-EUC0805 | C0805 | C43 | CAPACITOR, European symbol |  |  |  |  |  |  | C
2 | 4 | 22pf | C-EUC0805 | C0805 | C55, C56 | CAPACITOR, European symbol |  |  |  |  |  |  | C
8 | 16 | 4.7n | C-EUC0805 | C0805 | C6, C7, C25, C41, C42, C49, C50, C51 | CAPACITOR, European symbol |  |  |  |  |  |  | C
2 | 4 | 3.3uf | C-EUC1206 | C1206 | C88, C89 | CAPACITOR, European symbol |  |  |  |  |  |  | C
3 | 6 | 10uf | C-EUC1210 | C1210 | C83, C85, C87 | CAPACITOR, European symbol |  |  |  |  |  |  | C
1 | 2 | LE0 | LEDCHIP-LED0805 | CHIP-LED0805 | LE0 | LED
4 | 8 | Red | LEDCHIP-LED0805 | CHIP-LED0805 | CC, CV, LED2, PWR | LED
1 | 2 | 32.768kHz | CRYSTAL-32.768KHZPTH-2X6 | CRYSTAL-PTH-2X6-CYL | Y3 | 32.768kHz Crystal |  |  |  |  | XTAL-10112 |  |  | 32.768kHz
1 | 2 | 12Mhz | CRYSTALSMD-3.2X2.5 | CRYSTAL-SMD-3.2X2.5MM | Y2 | Crystals (Generic)
1 | 2 | 47uf 25V | CPOL-EUCT6032 | CT6032 | C32 | POLARIZED CAPACITOR, European symbol |  |  |  |  |  |  | C
1 | 2 | SMAJ13A | SMAJ13ASMA403A | DO214AC | D2 | DIODE
1 | 2 | LM317MABDT | LM317MABDT | DPACK | IC2 | 500 mA Adjustable Output Positive Voltage Regulator
3 | 6 | 10uf 16V | CPOL-EUE2-5 | E2-5 | C15, C20, C31 | POLARIZED CAPACITOR, European symbol |  |  |  |  |  |  | C
5 | 10 | 47uf 16V | CPOL-EUE2-5 | E2-5 | C53, C54, C80, C81, C82 | POLARIZED CAPACITOR, European symbol |  |  |  |  |  |  | C
3 | 6 | 47uf 25V | CPOL-EUE2-5 | E2-5 | C33, C35, C40 | POLARIZED CAPACITOR, European symbol |  |  |  |  |  |  | C
1 | 2 | 220uf 25v | CPOL-EUE3.5-8 | E3,5-8 | C26 | POLARIZED CAPACITOR, European symbol |  |  |  |  |  |  | C
1 | 2 | 22uf 25v | CPOL-EUE3.5-8 | E3,5-8 | C27 | POLARIZED CAPACITOR, European symbol |  |  |  |  |  |  | C
2 | 4 | EL357 | EL357 | EL357 | U$4, U$27
1 | 2 | 2A | FUSE | FUSE | F1 | FUSE
1 | 2 | STM32F427VIT6 | STM32F427VIT6 | LQFP100 | U$28 | STM32F405RGT6
1 | 2 | MICROSD-9P | MICRO-SD-CARD-HOLDER-9P | MICRO-SD9+4P-SMD-16.1X14.5X1.85MM | J3 | 320090008 |  |  |  |  |  |  |  | MICROSD-9P
1 | 2 | POWER_JACK | POWER_JACK | POWER_JACK_PTH | J2 | Power Jack Connector |  |  |  |  | CONN-08197
1 | 2 | MCP23008QFN20 | MCP23008QFN20 | QFN20 | IC16 | MCP23008
1 | 2 | 0R | R-EU_R0402 | R0402 | R76 | RESISTOR, European symbol |  |  |  |  |  |  | R
1 | 2 | NP | R-EU_R0402 | R0402 | R77 | RESISTOR, European symbol |  |  |  |  |  |  | R
2 | 4 | 1.8k 0.1% | R-US_R0603 | R0603 | R29, R31 | RESISTOR, American symbol |  |  |  |  |  |  | R
5 | 10 | 0R | R-US_R0805 | R0805 | R17, R30, R45, R46, R70 | RESISTOR, American symbol |  |  |  |  |  |  | R
1 | 2 | 1.5k | R-US_R0805 | R0805 | R63 | RESISTOR, American symbol |  |  |  |  |  |  | R
2 | 4 | 100R | R-US_R0805 | R0805 | R18, R19 | RESISTOR, American symbol |  |  |  |  |  |  | R
1 | 2 | 100k | R-US_R0805 | R0805 | R62 | RESISTOR, American symbol |  |  |  |  |  |  | R
2 | 4 | 10R | R-US_R0805 | R0805 | R22, R23 | RESISTOR, American symbol |  |  |  |  |  |  | R
20 | 40 | 10k | R-US_R0805 | R0805 | R11, R49, R51, R52, R53, R54, R56, R60, R61, R67, R68, R69, R71, R72, R73, R75, R78, R82, R83, R85 | RESISTOR, American symbol |  |  |  |  |  |  | R
3 | 6 | 18k 0.1% | R-US_R0805 | R0805 | R13, R26, R28 | RESISTOR, American symbol |  |  |  |  |  |  | R
4 | 8 | 1k | R-US_R0805 | R0805 | R39, R42, R43, R65 | RESISTOR, American symbol |  |  |  |  |  |  | R
2 | 4 | 1k 0.1% | R-US_R0805 | R0805 | R14, R86 | RESISTOR, American symbol |  |  |  |  |  |  | R
7 | 14 | 2.2k | R-US_R0805 | R0805 | R2, R5, R9, R21, R24, R32, R37 | RESISTOR, American symbol |  |  |  |  |  |  | R
3 | 6 | 20R | R-US_R0805 | R0805 | R57, R58, R79 | RESISTOR, American symbol |  |  |  |  |  |  | R
1 | 2 | 20k | R-US_R0805 | R0805 | R74 | RESISTOR, American symbol |  |  |  |  |  |  | R
3 | 6 | 220R | R-US_R0805 | R0805 | R20, R25, R33 | RESISTOR, American symbol |  |  |  |  |  |  | R
2 | 4 | 250R | R-US_R0805 | R0805 | R59, R15 | RESISTOR, American symbol |  |  |  |  |  |  | R
1 | 2 | 330R | R-US_R0805 | R0805 | R10 | RESISTOR, American symbol |  |  |  |  |  |  | R
6 | 12 | 470R | R-US_R0805 | R0805 | R4, R80, R81, R47, R84, R41 | RESISTOR, American symbol |  |  |  |  |  |  | R
1 | 2 | 500R | R-US_R0805 | R0805 | R55 | RESISTOR, American symbol |  |  |  |  |  |  | R
2 | 4 | 50R | R-US_R0805 | R0805 | R16, R44 | RESISTOR, American symbol |  |  |  |  |  |  | R
2 | 4 | 510R | R-US_R0805 | R0805 | R48, R50 | RESISTOR, American symbol |  |  |  |  |  |  | R
9 | 18 | 6.8k | R-US_R0805 | R0805 | R3, R6, R7, R8, R35, R36, R40, R64, R66 | RESISTOR, American symbol |  |  |  |  |  |  | R
2 | 4 | 680R | R-US_R0805 | R0805 | R1, R27 | RESISTOR, American symbol |  |  |  |  |  |  | R
1 | 2 | 9k | R-US_R0805 | R0805 | R38 | RESISTOR, American symbol |  |  |  |  |  |  | R
1 | 2 | NC | R-US_R0805 | R0805 | R34 | RESISTOR, American symbol |  |  |  |  |  |  | R
1 | 2 | 0R100 | R-EU_R2512 | R2512 | R12 | RESISTOR, European symbol |  |  |  |  |  |  | R
1 | 2 | S1M | S1M | SMA | D1
2 | 4 | LM358D | LM358D | SO08 | IC14, IC19 | OP AMP also LM158; LM258; LM2904
1 | 2 | OPA2196 | LM358D | SO08 | IC1 | OP AMP also LM158; LM258; LM2904
1 | 2 | OPA2197 | LM358D | SO08 | IC3 | OP AMP also LM158; LM258; LM2904
1 | 2 | OPA2197 | OPA2237U | SO08 | IC4 | Single-Supply Operational Amplifiers | TEXAS INSTRUMENTS | OPA2237UA | 1388075 | 80K6018
1 | 2 | W25Q32 | SPI_FLASH-X25XXSMD | SO08 | U1 | 32M Serial Flash Memory |  |  |  |  | N/A |  |  | 32M SPI Flash
1 | 2 | ISO1541D | ISO1541D | SO-08 | IC11
1 | 2 | MCP1501-20E/SN | MCP1501-20E/SN | SO-08 | IC5 |  |  |  |  |  |  |  | X
2 | 4 | 744053S | 744053S | SO16 | IC12, IC13 | Triple 2-channel analog multiplexer/demultiplexer
1 | 2 | REG1117 | REG1117 | SOT223 | IC18 | 800mA and 1A Low Dropout (LDO) Positive Regulator |  | REG1117 | 1097566 | 14P6981
1 | 2 | V_REG_317SMD | V_REG_317SMD | SOT223 | IC8 | Voltage Regulator
1 | 2 | 2N7002 | MOSFET-NCHANNELBSS138 | SOT23 | Q2 | Common NMOSFET Parts |  |  |  |  | TRANS-00830
4 | 8 | BAS40-04 | BAS40-04 | SOT23 | D3, D4, D7, D8 | Silicon Schottky Diodes
1 | 2 | BC847 | BC847 | SOT23 | T2 | NPN TRANSISTOR
1 | 2 | FDN340P | SMD-MOSFET-P-CH-20V-2A-FDN340P(SOT-23) | SOT-23 | Q3 | 305030026 |  | FDN340P |  |  |  |  |  | FDN340P
2 | 4 | MCP4726 | MCP4726 | SOT23-6 | IC6, IC7
1 | 2 | USBLC6-2P | USBLC6-2P | SOT23-6 | D5
2 | 4 | MMBT2222A | MMBT2222ALT1-NPN-SOT23-BEC | SOT23-BEC | T3, T4 | NPN Transistror
1 | 2 | PMBT3906 | MMBT3906LT1-PNP-SOT23-BEC | SOT23-BEC | T1 | PNP Transistror
2 | 4 | L79L05SOT89 | L79L05SOT89 | SOT89 | U$22, U$24
3 | 6 | SWITCH-SWITCH-SMD-3.0X4.0X2.0MM | SWITCH-SWITCH-SMD-3.0X4.0X2.0MM | TACTILE_SWITCH_SMD_6.0X3.5MM | K15, RST, WK_UP
1 | 2 | TIP147 | TIP42C | TO220AV | Q4 | PNP TRANSISTOR
1 | 2 | 7805DT | 7805DT | TO252 | IC17 | Positive VOLTAGE REGULATOR
1 | 2 | MCP9700 | MCP9700 | TO92-BCE | U$20
1 | 2 | TIP147 | TIP2955 | TOP3AV | Q1 | PNP TRANSISTOR
1 | 2 | CS4344 | CS4344 | TSSOP10 | U$29
1 | 2 | MCP3428TSSOP | MCP3428TSSOP | TSSOP14 | IC15
1 | 2 | USB-FS | USBMINIB | USB-MINIB | USB | USB Connectors

Sheet: Decade
Qty | Finalqty | Value | Device | Package | Parts | Description | SPICEPREFIX
70 | 350 |  | JP2 | JP2 | JP52, JP53, JP54, JP55, JP56, JP57, JP58, JP59, JP60, JP61, JP63, JP64, JP65, JP66, JP67, JP68, JP69, JP70, JP71, JP72, JP73, JP74, JP75, JP76, JP77, JP78, JP79, JP80, JP81, JP82, JP83, JP84, JP85, JP86, JP87, JP88, JP89, JP90, JP91, JP92, JP93, JP94, JP95, JP96, JP97, JP98, JP99, JP100, JP101, JP102, JP103, JP104, JP105, JP106, JP107, JP108, JP109, JP110, JP111, JP112, JP113, JP114, JP115, JP116, JP117, JP118, JP119, JP120, JP121, JP122 | JUMPER
51 | 255 |  | JP2E | JP2@1 | JP1, JP2, JP3, JP4, JP5, JP6, JP7, JP8, JP9, JP10, JP11, JP12, JP13, JP14, JP15, JP16, JP17, JP18, JP19, JP20, JP21, JP22, JP23, JP24, JP25, JP26, JP27, JP28, JP29, JP30, JP31, JP32, JP33, JP34, JP35, JP36, JP37, JP38, JP39, JP40, JP41, JP42, JP43, JP44, JP45, JP46, JP47, JP48, JP49, JP50, JP123 | JUMPER
2 | 10 |  | PINHD-1X2 | 1X02 | JP51, JP62 | PIN HEADER |  | R
1 | 5 | 1k | R-US_R0805 | R0805 | R64 | RESISTOR, American symbol | R | R
9 | 45 | 100R | R-US_R1210 | R1210 | R37, R38, R39, R40, R41, R42, R43, R44, R45 | RESISTOR, American symbol | R | C
9 | 45 | 100k | R-US_R0805 | R0805 | R10, R11, R12, R13, R14, R15, R16, R17, R18 | RESISTOR, American symbol | R | C
10 | 50 | 100nf | C-EUC0805 | C0805 | C11, C12, C13, C14, C15, C16, C17, C18, C19, C20 | CAPACITOR, European symbol | C | C
10 | 50 | 100pf | C-EUC0805 | C0805 | C41, C42, C43, C44, C45, C46, C47, C48, C49, C50 | CAPACITOR, European symbol | C | R
9 | 45 | 10R | R-US_R1210 | R1210 | R46, R47, R48, R49, R50, R51, R52, R53, R54 | RESISTOR, American symbol | R | C
9 | 45 | 10k | R-US_R0805 | R0805 | R19, R20, R21, R22, R23, R24, R25, R26, R27 | RESISTOR, American symbol | R | C
10 | 50 | 10nf | C-EUC0805 | C0805 | C21, C22, C23, C24, C25, C26, C27, C28, C29, C30 | CAPACITOR, European symbol | C
9 | 45 | 1M | R-US_R0805 | R0805 | R1, R2, R3, R4, R5, R6, R7, R8, R9 | RESISTOR, American symbol | R
9 | 45 | 1R | R-US_R1206 | R1206 | R55, R56, R57, R58, R59, R60, R61, R62, R63 | RESISTOR, American symbol | R
9 | 45 | 1k | R-US_R1210 | R1210 | R28, R29, R30, R31, R32, R33, R34, R35, R36 | RESISTOR, American symbol | R
10 | 50 | 1nf | C-EUC0805 | C0805 | C31, C32, C33, C34, C35, C36, C37, C38, C39, C40 | CAPACITOR, European symbol | C
10 | 50 | 1uf | C-EUC1206 | C1206 | C1, C2, C3, C4, C5, C6, C7, C8, C9, C10 | CAPACITOR, European symbol | C
2 | 10 | MKDSN1,5/2-5,08 | MKDSN1,5/2-5,08 | MKDSN1,5/2-5,08 | X1, X3 | MKDSN 1,5/ 2-5,08 Printklemme

Sheet: Busblaster
Qty | Value | Device | Package | Parts | Description | MF | MPN | OC_FARNELL | OC_NEWARK | SPICEPREFIX
1 |  | JP1EJP | 1X02 | JP4 | JUMPER
1 |  | PINHD-1X5 | 1X05 | JP3 | PIN HEADER
1 |  | PINHD-1X6 | 1X06 | JP1 | PIN HEADER
1 |  | PINHD-1X9 | 1X09 | JP2 | PIN HEADER
1 |  | PINHEAD_-_COPY_PINHD-2X10SHROUDED | PINHEAD_-_COPY_PINSHRD_PTH_2X10 | JTAG | PIN HEADER
1 | 100R | RESISTORR1206 | R1206 | R8
16 | 100nF | CAPC603 | C603 | C1, C2, C3, C4, C5, C6, C7, C13, C14, C15, C16, C17, C18, C19, C20, C21
1 | 10K | R-US_R0805 | R0805 | R12 | RESISTOR, American symbol |  |  |  |  | R
1 | 10k | RNETWORK | RN8P-4R-CRA06S | RN3 | 4 Resistor Array 0603
1 | 12K | R-US_R0805 | R0805 | R1 | RESISTOR, American symbol |  |  |  |  | R
1 | 12Mhz | CRYSTALHC49UP | HC49UP | Q1 | CRYSTAL |  |  | unknown | unknown
1 | 1K | R-US_R0805 | R0805 | R2 | RESISTOR, American symbol |  |  |  |  | R
1 | 2.2K | R-US_R0805 | R0805 | R6 | RESISTOR, American symbol |  |  |  |  | R
2 | 22pf | CAPC603 | C603 | C9, C10
2 | 2K | R-US_R0805 | R0805 | R10, R11 | RESISTOR, American symbol |  |  |  |  | R
1 | 3.3uF | CAP_POLSMC_A | SMC_A | C8
1 | 3.6V Zener | ZENERSOD-123 | SOD-123 | D1 | Zener Diode SOD-323
3 | 4.7uF | CAP_POLSMC_A | SMC_A | C11, C12, C22
9 | 82R | R-US_R0805 | R0805 | R3, R4, R5, R7, R9, R13, R14, R15, R16 | RESISTOR, American symbol |  |  |  |  | R
1 | 93C46 | 93C46 | SOIC8 | IC2
1 | CON-USB-MINI-BUSB1 | CON-USB-MINI-BUSB1 | CONN_USB_MINI-B | USB | USB connector
2 | FB | FERRITE_BEAD603 | FB603 | L1, L2
1 | FT2232H | FT2232H | LQFP64 | IC1 | DUAL HIGH SPEED USB TO MULTIPURPOSE UART/FIFO IC
1 | LD1117-3.3 | LD1117-3.3 | SOT223 | IC3
1 | Red | LED805 | LED-805 | LED
1 | Red | LEDCHIPLED_0805 | CHIPLED_0805 | PWR | LED
1 | Reset | SW-SMD-SMALL | TACT_SWITCH_SMALL | PB
1 | XC2C32A_VQ44_2 | XC2C32A_VQ44_2 | VQ44 | IC4 | xc2c32a_vq44-ian edit this description

Sheet: Bus Pirate
Qty | Value | Device | Package | Parts | Description | MF | MPN | OC_FARNELL | OC_NEWARK | PROD_ID | SPICEPREFIX
1 |  | PINHD-1X5 | 1X05 | ICSP | PIN HEADER
5 | 0.1uF | CAPC603 | C603 | C1, C2, C3, C4, C5
3 | 1uF | CAPC603 | C603 | C7, C8, C9
2 | 22pf | CAPC603 | C603 | C12, C13
8 |  | LEDCHIP-LED0805 | CHIP-LED0805 | LED1, LED1A, LED2, LED2A, LED3, LED3A, LED4, LED4A | LED
1 | CON-USB-MINI-BUSB1 | CON-USB-MINI-BUSB1 | CONN_USB_MINI-B | J1 | USB connector
1 | 12MHz | CRYSTALHC49S | HC49/S | Q1 | CRYSTAL |  |  | 1667008 | unknown
1 | LOGO_CC-0 | LOGO_CC-0 | LOGO_CC-0 | LOGO1
1 | HEADER2X5-SHRD-PTH-B | HEADER2X5-SHRD-PTH-B | PINSHRD_PTH_2X05B | IO | Shrouded pin header, 2.54mm pitch
4 | 1k | R-US_R0805 | R0805 | R2, R3, R4, R6 | RESISTOR, American symbol |  |  |  |  |  | R
2 | 2K | R-US_R0805 | R0805 | R1, R5 | RESISTOR, American symbol |  |  |  |  |  | R
3 | 10k | RNETWORK | RN8P-4R-CRA06S | RN1, RN2, RN3 | 4 Resistor Array 0603
2 | 10uF | CPOL-EUSMCA | SMC_A | C10, C11 | POLARIZED CAPACITOR, European symbol
1 | CH340G | CH340GSMD | SO016 | U1 | A simple USB 2.0 to Serial IC. |  |  |  |  | IC-13498
2 | ME6206A33P1G | MIC5205 | SOT-23-5 | VR1, VR2 | 150ma Low-Noise LDO Regulator
1 | PIC24FJ64GA002 | PIC24FJ64GA002 | SSOP28 | IC1 | 16-bit General Purpose Flash Microcontroller
1 | FDN340P | FDN340P | SUPER-SOT3 | Q2 | Single P-Channel, PowerTrench (R) MOSFET
1 | 4066 | 4066 | TSSOP14 | IC3 | Quad bilateral ANALOG SWITCH
1 | 700mA+ ferrite | WE-KIL_0805 | WE-KI_0805_B | L1 | SMD Wire Wound Ceramic Inductor WE-KIL
1 | TJ5205SF5-5.0 | MIC5205 | SOT-23-5 | VR3 | 150ma Low-Noise LDO Regulator

Sheet: CPLD
Qty | Value | Device | Package | Parts | Description | SPICEPREFIX
2 |  | PINHD-1X17 | 1X17 | JP1, JP2 | PIN HEADER
1 |  | PINHD-1X2 | 1X02 | JP3 | PIN HEADER
1 |  | PINHD-1X6 | 1X06 | JTAG | PIN HEADER
1 |  | SJ | SJ | SJ1 | SMD solder JUMPER
1 | AP2204K-3.3TRG1 | AP2204K-3.3TRG1 | SOT-23-5 | U3 | 150ma Low-Noise LDO Regulator
5 | 0.1uF | CAPC603 | C603 | C1, C2, C3, C4, C8
1 | 10K | R-US_R0805 | R0805 | R1 | RESISTOR, American symbol | R
3 | 2K | R-US_R0805 | R0805 | R2, R3, R4 | RESISTOR, American symbol | R
4 | 3.3uF | CAP_POLSMC_A | SMC_A | C5, C6, C7, C9
1 | NCP114ASN180T1G | NCP114ASN180T1G | SOT-23-5 | U2 | 150ma Low-Noise LDO Regulator
1 | OSC-OSCILLATOR | OSC-OSCILLATOR | OSCILLATOR_7X5_SMD | Q1 | Oscillator
1 | SMD button small | SMD_TACT_SMALL | TACT_SWITCH_SMALL | PB
1 | XC2C32A_VQ44_2 | XC2C32A_VQ44_2 | VQ44 | U1 | xc2c32a_vq44-ian edit this description
3 | Yellow LED | LED805 | LED-805 | D1, D2, PWR

Sheet: TMS320F23027
Qty | Value | Device | Package | Parts | Description | MF | MPN | OC_FARNELL | OC_NEWARK | PROD_ID | SPICEPREFIX | VALUE
2 |  | PINHD-1X20 | 1X20 | JP1, JP2 | PIN HEADER
1 | 0.1uf | C-USC0603 | C0603 | C8 | CAPACITOR, American symbol |  |  |  |  |  | C
4 | 2.2uf | C-USC0805 | C0805 | C1, C3, C4, C5 | CAPACITOR, American symbol |  |  |  |  |  | C
2 | 0.1uF | CAPC603 | C603 | C2, C6
2 | 22pf | CAPC603 | C603 | C12, C13
1 | RX(RED) | LEDCHIP-LED0805 | CHIP-LED0805 | RX | LED
1 | TX(Green) | LEDCHIP-LED0805 | CHIP-LED0805 | TX | LED
1 | CON-USB-MINI-BUSB1 | CON-USB-MINI-BUSB1 | CONN_USB_MINI-B | J1 | USB connector
1 | 12MHz | CRYSTALHC49S | HC49/S | Q1 | CRYSTAL |  |  | 1667008 | unknown
1 | 10mH | INDUCTOR/FERRITE-BEAD0805 | INDUCTOR_L0805 | L1
1 | 1mH | INDUCTOR/FERRITE-BEAD0805 | INDUCTOR_L0805 | L2
1 | TMS320F28027PTTHCTSMD | TMS320F28027PTTHCTSMD | LQFP-48 | IC3
1 | 2.2k | R-US_R0805 | R0805 | R1 | RESISTOR, American symbol |  |  |  |  |  | R
1 | 5k | R-US_R0805 | R0805 | R2 | RESISTOR, American symbol |  |  |  |  |  | R
2 | 1K | R-US_R0805 | R0805 | R3, R4
1 | 10uF | CPOL-EUSMCA | SMC_A | C10 | POLARIZED CAPACITOR, European symbol
1 | 10uf | CPOL-USSMCA | SMC_A | C9 | POLARIZED CAPACITOR, American symbol |  |  |  |  |  | C
1 | CH340G | CH340GSMD | SO016 | IC2 | A simple USB 2.0 to Serial IC. |  |  |  |  | IC-13498 |  | CH340G
1 | ME6206A33P1G | ME6206A33P1G | SOT89 | IC1
2 | FDN340P | FDN340P | SUPER-SOT3 | Q2, Q3 | Single P-Channel, PowerTrench (R) MOSFET
1 | SWITCH-SWITCH-SMD-3.0X4.0X2.0MM | SWITCH-SWITCH-SMD-3.0X4.0X2.0MM | TACTILE_SWITCH_SMD_6.0X3.5MM | RESET

Sheet: Jatagulator
Qty | Value | Device | Package | Parts | Description
1 |  | PINHD-1X6 | 1X06 | JP4 | PIN HEADER
2 |  | PINHD-2X4 | 2X04 | JP2, JP3 | PIN HEADER
1 |  | PINHD-2X5 | 2X05 | JP1 | PIN HEADER
1 | 0.01uf | C-USC0805 | C0805 | C5 | CAPACITOR, American symbol
4 | 0.1uf | C-USC0603 | C0603 | C18, C19, C20, C21 | CAPACITOR, American symbol
7 | 0.1uf | C-USC0805 | C0805 | C8, C10, C11, C12, C13, C14, C15 | CAPACITOR, American symbol
1 | 100k | R-US_R0805 | R0805 | R8 | RESISTOR, American symbol
4 | 10k | R-US_R0805 | R0805 | R2, R3, R6, R7 | RESISTOR, American symbol
2 | 10uf | CPOL-USE2.5-5 | E2,5-5 | C1, C9 | POLARIZED CAPACITOR, American symbol
1 | 18k | R-US_R0805 | R0805 | R9 | RESISTOR, American symbol
1 | 1nf | C-USC0805 | C0805 | C6 | CAPACITOR, American symbol
1 | 24LC256 | EEPROM-I2CSMD | SO08 | U2 | I2C EEPROMs, 24LC256 and others
1 | 270R | R-US_R0805 | R0805 | R5 | RESISTOR, American symbol
2 | 4.7uf | C-USC0805 | C0805 | C16, C17 | CAPACITOR, American symbol
1 | 470R | R-US_R0805 | R0805 | R4 | RESISTOR, American symbol
1 | 470pf | C-USC0805 | C0805 | C7 | CAPACITOR, American symbol
1 | 5MHz | CRYSTALSMD-5X3.2-4PAD | CRYSTAL-SMD-5X3.2-4PAD | Y1 | Crystals (Generic)
1 | 8.2k | R-US_R0805 | R0805 | R10 | RESISTOR, American symbol
1 | AD8655R | AD8655R | SO8 | IC2 | Low Noise, Precision CMOS Amplifier
6 | 1K | CTS742C083 | CTS742C083 | RN1, RN2, RN3, RN4, RN5, RN6 | Chip Resistor Array 4 Single Resistor
1 | Green | LEDCHIP-LED0805 | CHIP-LED0805 | STAT | LED
1 | MMBT3904 | MMBT3904LT1-NPN-SOT23-BEC | SOT23-BEC | T1 | NPN Transistror
1 | MOMENTARY-SWITCH-SPST-SMD-6.2MM-TALL | MOMENTARY-SWITCH-SPST-SMD-6.2MM-TALL | TACTILE_SWITCH_SMD_6.2MM_TALL | S1 | Momentary Switch (Pushbutton) - SPST
1 | P8X32A | P8X32A-Q44 | P8X32A-Q44_MCU | U1 | Propellor uC
1 | REG1117 | REG1117 | SOT223 | IC3 | 800mA and 1A Low Dropout (LDO) Positive Regulator
1 | Red | LEDCHIP-LED0805 | CHIP-LED0805 | LED4 | LED
6 | SRV05-4-N | WE-TVS_SOT23-6L_HS_824015 | WE-TVS_SOT23-6L | D1, D2, D3, D4, D5, D6 | WE-TVS TVS Diode – High Speed Series
3 | TXS0108 | LOGIC-TXS0108EPWR(TSSOP20) | TSSOP20-0.65-6.5X4.4MM | U3, U4, U5 | 310050026
