lgv2018/Power-Supply/schematic/Powersupply_RevA_discrete.pdf

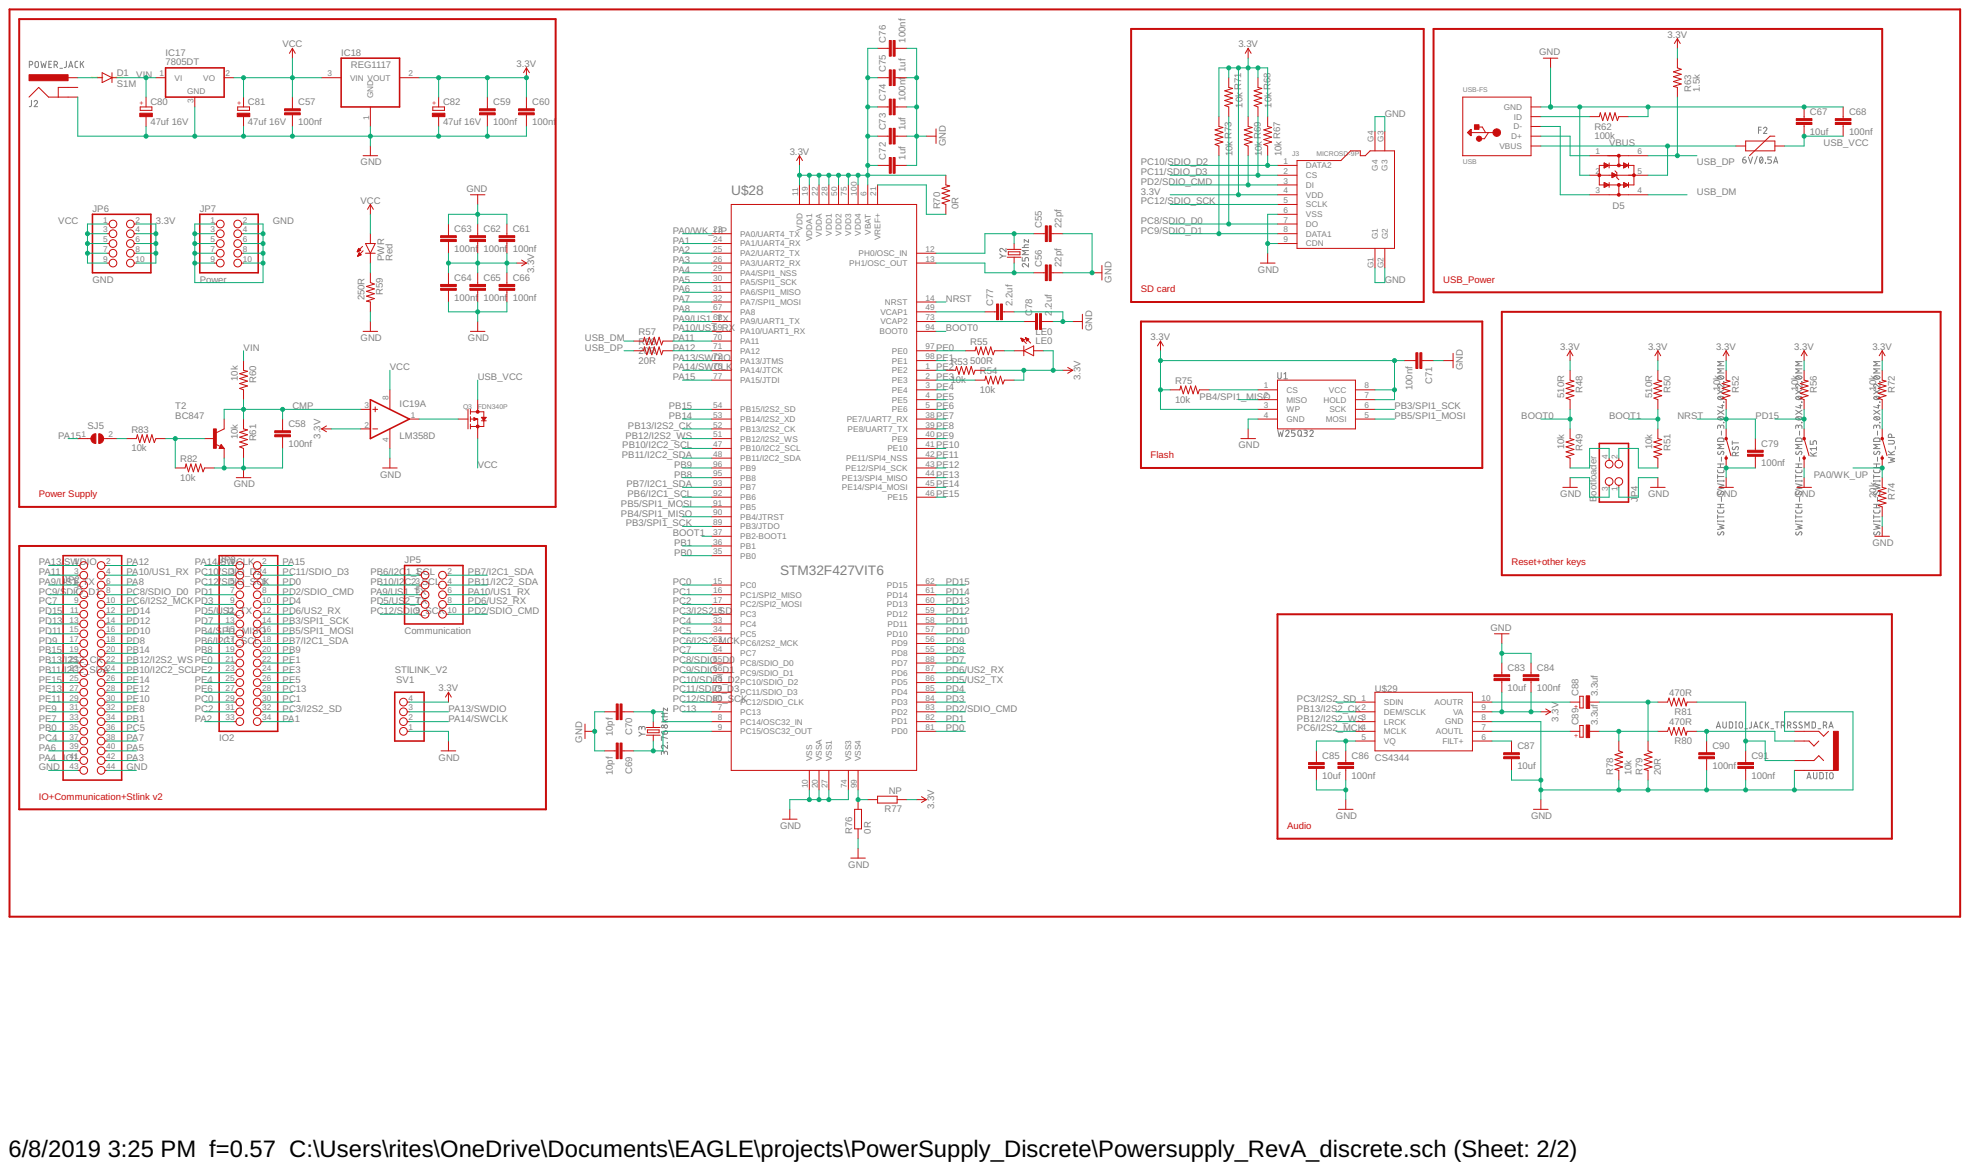
[picture p1: page 1]

GND

38 PE8/UART7_TX PE7 | Flash

6/8/2019 3:25 PM f=0.57 C:\Users\rites\OneDrive\Documents\EAGLE\projects\PowerSupply_Discrete\Powersupply_RevA_discrete.sch (Sheet: 2/2)
