lgv2018/Power-Supply/schematic/Powersupply_RevA_discrete.brd

## EAGLE design schematic/Powersupply_RevA_discrete.brd (2019-09-19)

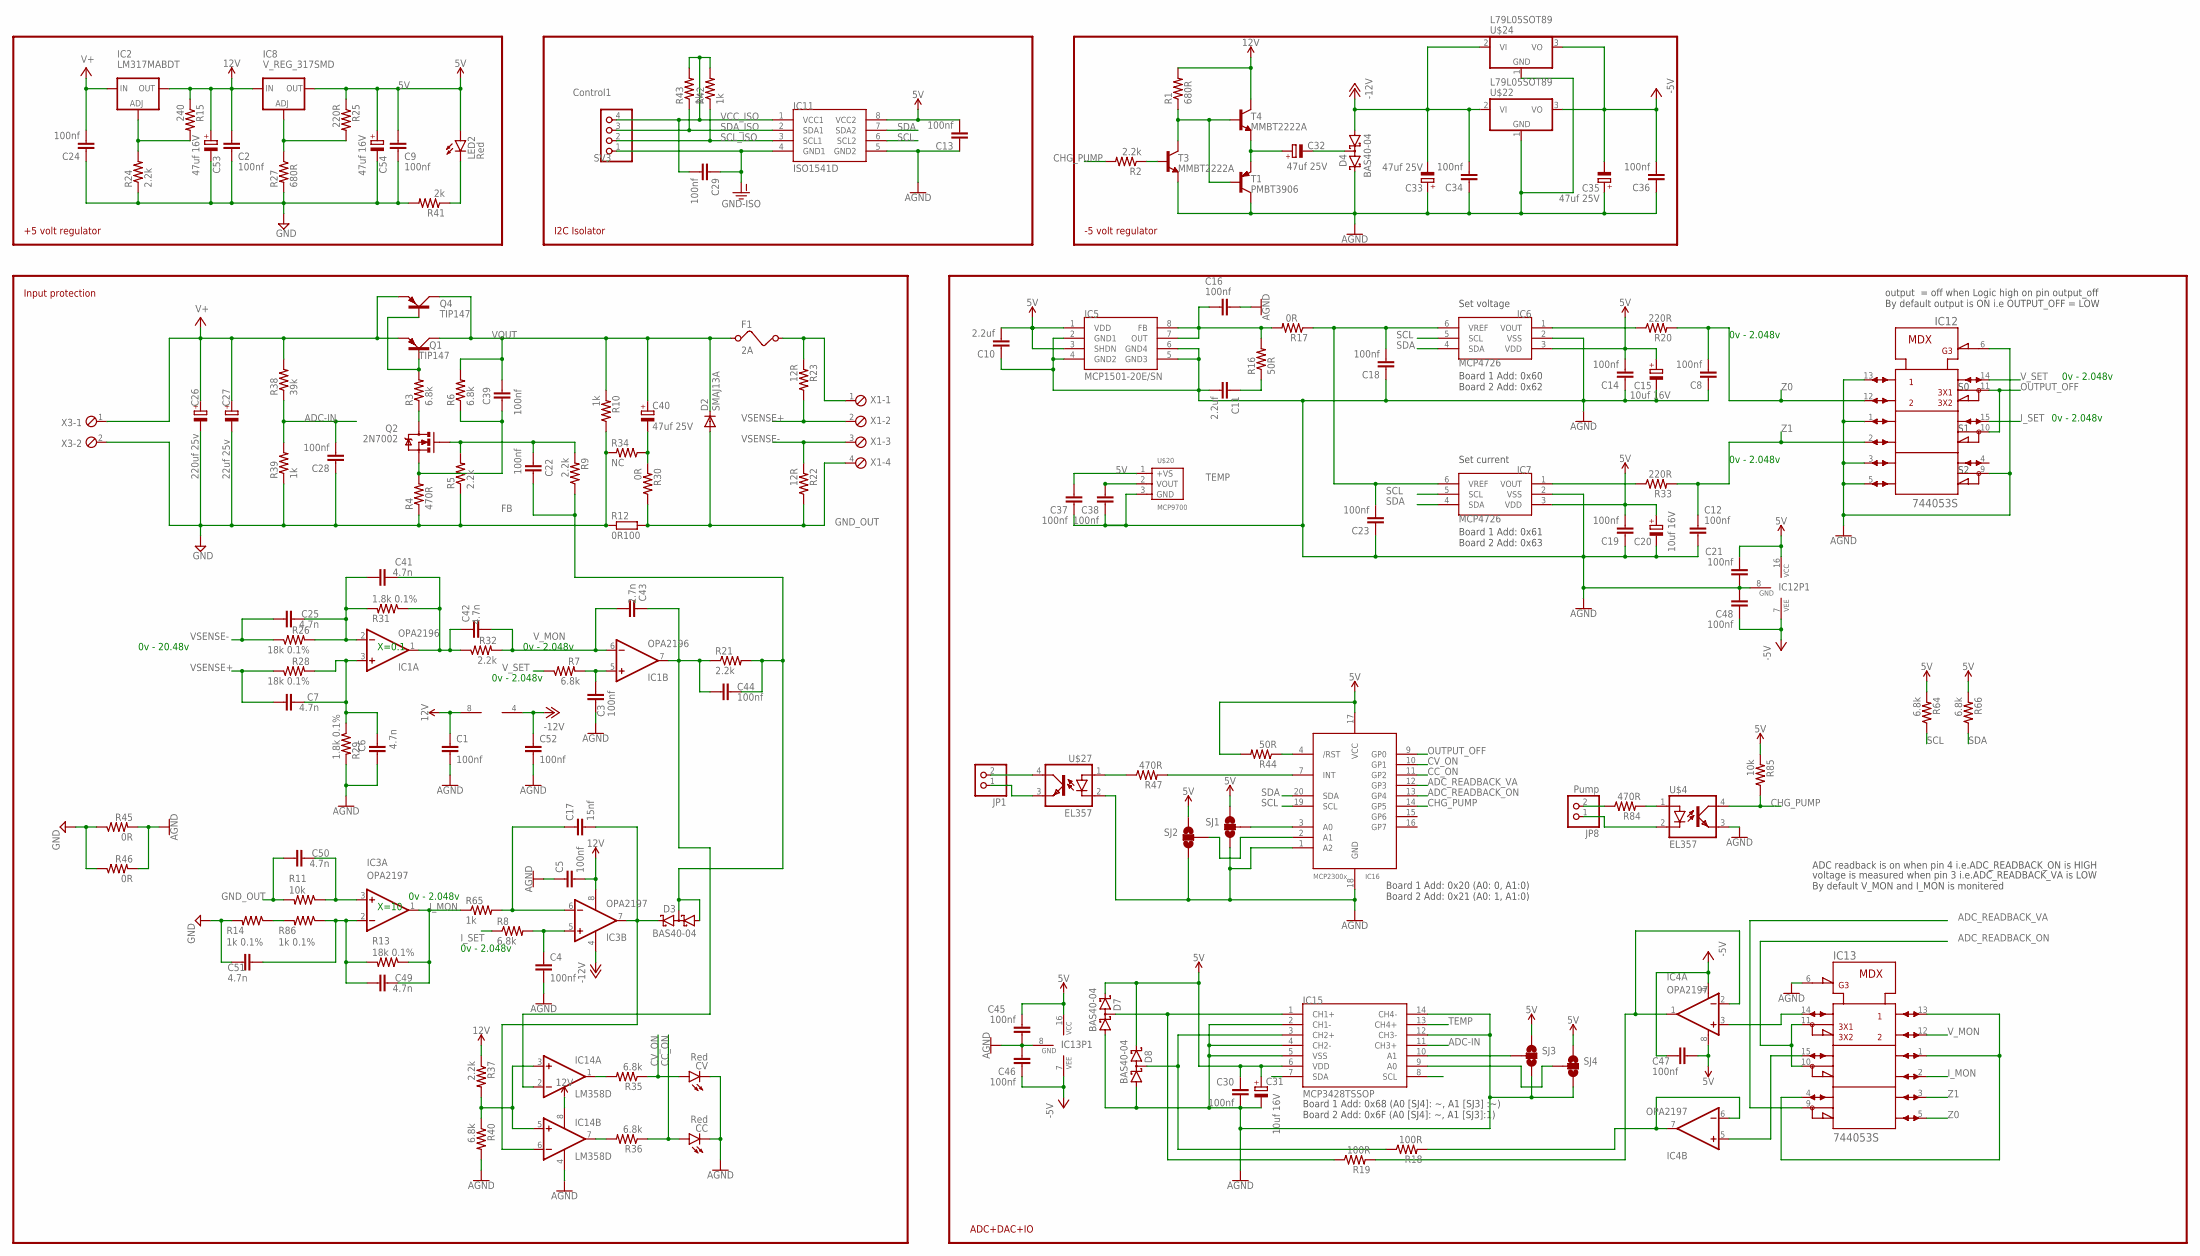
[picture p2: schematic Powersupply_RevA_discrete.sch, sheet 1]

Parts:
C1, C2, C3, C5, C8, C9, C12, C13, C14, C16, C18, C19, C21, C23, C24, C28, C29, C30, C34, C36, C37, C38, C39, C44, C45, C46, C47, C48, C52: 100nf; C0603
C4, C22: 100nf; C0805
C6, C7, C25, C41, C42, C49, C50, C51: 4.7n; C0805
C10, C11: 2.2uf; C0805
C15, C20, C31: 10uf 16V; E2-5
C17: 15nf; C0805
C26: 220uf 25v; E3,5-8
C27: 22uf 25v; E3,5-8
C32: 47uf 25V; CT6032
C33, C35, C40: 47uf 25V; E2-5
C43: 2.7n; C0805
C53, C54: 47uf 16V; E2-5
CC: Red; CHIP-LED0805
CV: Red; CHIP-LED0805
D2: SMAJ13A; DO214AC
D3, D4, D7, D8: BAS40-04; SOT23
F1: 2A; FUSE
IC1: OPA2196; SO08
IC2: LM317MABDT; DPACK
IC3, IC4: OPA2197; SO08
IC5: MCP1501-20E/SN; SO-08
IC6, IC7: MCP4726; SOT23-6
IC8: V_REG_317SMD; SOT223
IC11: ISO1541D; SO-08
IC12, IC13: 744053S; SO16
IC14: LM358D; SO08
IC15: MCP3428TSSOP; TSSOP14
IC16: MCP23008QFN20; QFN20
JP1: PINHD-1X2; 1X02
JP8: Pump; 1X02
LED2: Red; CHIP-LED0805
Q1: TIP147; TOP3AV
Q2: 2N7002; SOT23
Q4: TIP147; TO220AV
R1, R27: 680R; R0805
R2, R5, R9, R21, R24, R32, R37: 2.2k; R0805
R3, R6, R7, R8, R35, R36, R40, R64, R66: 6.8k; R0805
R4, R47, R84: 470R; R0805
R10, R39, R42, R43, R65: 1k; R0805
R11, R85: 10k; R0805
R12: 0R100; R2512
R13, R26, R28: 18k 0.1%; R0805
R14, R86: 1k 0.1%; R0805
R15: 240; R0805
R16, R44: 50R; R0805
R17, R30, R45, R46: 0R; R0805
R18, R19: 100R; R0805
R20, R25, R33: 220R; R0805
R22, R23: 12R; R0805
R29, R31: 1.8k 0.1%; R0603
R34: NC; R0805
R38: 39k; R0805
R41: 2k; R0805
SJ1, SJ2, SJ3, SJ4: SOLDERJUMPER_2WAY-OLDS; SJ_3
SV3: Control1; 1X04
T1: PMBT3906; SOT23-BEC
T3, T4: MMBT2222A; SOT23-BEC
U$4, U$27: EL357
U$20: MCP9700; TO92-BCE
U$22, U$24: L79L05SOT89; SOT89
X1: MPT4; 4POL254
X3: MPT2; 2POL254

Connections:
5V: C9.2, C10.2, C13.2, C14.2, C15.+, C19.2, C20.+, C21.2, C30.2, C31.+, C37.2, C45.2, C47.1, C54.+, D7.2 (C2), D8.2 (C2), IC4.8 (V+), IC5.1 (VDD), IC5.3 (SHDN), IC6.3 (VDD), IC7.3 (VDD), IC8.2 (OUT), IC11.8 (VCC2), IC12.16 (VCC), IC13.16 (VCC), IC15.6 (VDD), IC16.17 (VCC), LED2.A, R25.1, R44.2, R64.2, R66.2, R85.2, SJ1.1, SJ2.1, SJ3.1, SJ4.1, U$20.1 (+VS)
12V: C1.1, C2.2, C5.2, C53.+, IC1.8 (V+), IC2.4 (OUT), IC3.8 (V+), IC8.3 (IN), IC14.8 (V+), R1.2, R15.1, R37.1, T4.C
-5V: C35.-, C36.2, C46.1, C47.2, C48.1, IC4.4 (V-), IC12.7 (VEE), IC13.7 (VEE), U$22.3 (VO), U$24.3 (VO)
-12V: C33.-, C34.2, C52.1, D4.1 (A1), IC1.4 (V-), IC3.4 (V-), U$22.2 (VI), U$24.2 (VI)
ADC-IN: C28.2, IC15.11 (CH3+), R38.1, R39.2
ADC-IOUT: IC4.6 (-IN), IC4.7 (OUT), R18.2
ADC-VOUT: IC4.1 (OUT), IC4.2 (-IN), R19.2
ADC_READBACK_ON: IC13.10, IC13.11, IC16.13 (GP4)
ADC_READBACK_VA: IC13.9, IC16.12 (GP3)
AGND: C1.2, C3.2, C4.2, C5.1, C6.2, C8.1, C10.1, C11.2, C12.1, C13.1, C14.1, C15.-, C16.2, C18.1, C19.1, C20.-, C21.1, C23.1, C30.1, C31.-, C33.+, C34.1, C35.+, C36.1, C37.1, C38.1, C45.1, C46.2, C48.2, C52.2, CC.C, CV.C, D4.2 (C2), D7.1 (A1), D8.1 (A1), IC5.2 (GND1), IC5.4 (GND2), IC5.5 (GND3), IC5.6 (GND4), IC6.2 (VSS), IC7.2 (VSS), IC11.5 (GND2), IC12.1, IC12.3, IC12.5, IC12.6 (!G), IC12.8 (GND), IC12.9, IC12.13, IC13.6 (!G), IC13.8 (GND), IC14.4 (V-), IC15.2 (CH1-), IC15.4 (CH2-), IC15.5 (VSS), IC15.12 (CH3-), IC15.14 (CH4-), IC16.1 (A2), IC16.18 (GND), R29.2, R40.2, R45.2, R46.2, SJ1.3, SJ2.3, SJ3.3, SJ4.3, T1.C, T3.E, U$4.3 (EMIT), U$20.3 (GND), U$22.1 (GND), U$24.1 (GND), U$27.2 (C)
CC_ON: CC.A, IC16.11 (GP2), R36.1
CHG_PUMP: IC16.14 (GP5), R2.2, R85.1, U$4.4 (COL)
CV_ON: CV.A, IC16.10 (GP1), R35.1
FB: C22.2, C44.1, D3.1 (A1), D3.3 (C1A2), R9.1, R21.2
GND: C2.1, C9.1, C24.1, C26.-, C27.-, C28.1, C51.1, C53.-, C54.-, R4.1, R5.1, R10.1, R12.1, R14.2, R24.1, R27.2, R34.2, R39.1, R41.2, R45.1, R46.1, X3.2; also elsewhere on the board
GND-ISO: C29.1, IC11.4 (GND1), SV3.1
GND_OUT: C50.2, D2.A, R11.2, R12.2, R22.1, R30.1, X1.4
I_MON: C49.1, IC3.1 (OUT), IC13.2, R13.1, R65.1
I_SET: IC12.15, R8.1
unnamed: C17.1, IC3.6 (-IN), R65.2
unnamed: IC2.1 (ADJ), R15.2, R24.2
unnamed: C50.1, IC3.3 (+IN), R11.1
unnamed: C49.2, C51.2, IC3.2 (-IN), R13.2, R86.1
unnamed: F1.2, R23.2, X1.1
unnamed: R47.1, U$27.1 (A)
unnamed: C25.1, C41.2, IC1.2 (-IN), R26.2, R31.2
unnamed: C16.1, IC5.7 (OUT), IC5.8 (FB), R16.2, R17.2
unnamed: IC14.3 (+IN), IC14.5 (+IN), R37.2, R40.1
unnamed: C43.2, C44.2, IC1.7 (OUT), IC14.2 (-IN), R21.1
unnamed: C6.1, C7.1, IC1.3 (+IN), R28.2, R29.1
unnamed: C17.2, D3.2 (C2), IC3.7 (OUT), IC14.6 (-IN)
unnamed: IC8.1 (ADJ), R25.2, R27.1
unnamed: IC7.1 (VOUT), R33.1
unnamed: C11.1, R16.1
unnamed: C3.1, IC1.5 (+IN), R7.2
unnamed: C4.1, IC3.5 (+IN), R8.2
unnamed: D8.3 (C1A2), IC15.3 (CH2+), R18.1
unnamed: C40.-, R30.2, R34.1
unnamed: IC16.4 (/RST), R44.1
unnamed: IC16.3 (A0), SJ1.2
unnamed: IC4.3 (+IN), IC13.14
unnamed: Q1.B, Q4.B, R3.2
unnamed: LED2.C, R41.1
unnamed: IC4.5 (+IN), IC13.15
unnamed: D7.3 (C1A2), IC15.1 (CH1+), R19.1
unnamed: IC14.1 (OUT), R35.2
unnamed: IC16.2 (A1), SJ2.2
unnamed: IC15.10 (A1), SJ3.2
unnamed: IC15.9 (A0), SJ4.2
unnamed: R2.1, T3.B
unnamed: Q2.3 (D), R3.1
unnamed: R1.1, T1.B, T3.C, T4.B
unnamed: IC13.1, IC13.4, IC13.13
unnamed: C32.+, T1.E, T4.E
unnamed: C32.-, D4.3 (C1A2)
unnamed: IC6.1 (VOUT), R20.1
unnamed: C22.1, Q2.1 (G), R5.2, R9.2
unnamed: IC14.7 (OUT), R36.2
unnamed: C39.1, Q2.2 (S), R4.2, R6.1
unnamed: JP1.2, U$27.4 (COL)
unnamed: C41.1, C42.2, IC1.1 (OUT), R31.1, R32.1
unnamed: JP1.1, U$27.3 (EMIT)
unnamed: IC16.7 (INT), R47.2
unnamed: JP8.2, R84.1
unnamed: R84.2, U$4.1 (A)
unnamed: JP8.1, U$4.2 (C)
unnamed: R14.1, R86.2
OUTPUT_OFF: IC12.10, IC12.11, IC16.9 (GP0)
SCL: IC6.5 (SCL), IC7.5 (SCL), IC11.6 (SCL2), IC15.8 (SCL), IC16.19 (SCL), R64.1
SCL_ISO: IC11.3 (SCL1), R42.1, SV3.2
SDA: IC6.4 (SDA), IC7.4 (SDA), IC11.7 (SDA2), IC15.7 (SDA), IC16.20 (SDA), R66.1
SDA_ISO: IC11.2 (SDA1), R43.1, SV3.3
TEMP: C38.2, IC15.13 (CH4+), U$20.2 (VOUT)
V+: C24.2, C26.+, C27.+, IC2.3 (IN), Q1.E, Q4.E, R38.2, X3.1
VCC_ISO: C29.2, IC11.1 (VCC1), R42.2, R43.2, SV3.4
VOUT: C39.2, C40.+, D2.C, F1.1, Q1.C, Q4.C, R6.2, R10.2
VREF: C18.2, C23.2, IC6.6 (VREF), IC7.6 (VREF), R17.1
VSENSE+: C7.2, R23.1, R28.1, X1.2
VSENSE-: C25.2, R22.2, R26.1, X1.3
V_MON: C42.1, C43.1, IC1.6 (-IN), IC13.12, R32.2
V_SET: IC12.14, R7.1
Z0: C8.2, IC12.12, IC13.5, R20.2
Z1: C12.2, IC12.2, IC13.3, R33.2

Notes on the sheet:
+5 volt regulator
ADC+DAC+IO
Input protection
Board 1 Add: 0x60 Board 2 Add: 0x62
Board 1 Add: 0x61 Board 2 Add: 0x63
Board 1 Add: 0x68 (A0 [SJ4]: ~, A1 [SJ3] :~) Board 2 Add: 0x6F (A0 [SJ4]: ~, A1 [SJ3]:1)
Set voltage
Set current
X=10
X=0.1
0v - 20.48v
0v - 2.048v
-5 volt regulator
I2C Isolator
output = off when Logic high on pin output_off By default output is ON i.e OUTPUT_OFF = LOW
ADC readback is on when pin 4 i.e.ADC_READBACK_ON is HIGH
voltage is measured when pin 3 i.e.ADC_READBACK_VA is LOW By default V_MON and I_MON is monitered
Board 1 Add: 0x20 (A0: 0, A1:0) Board 2 Add: 0x21 (A0: 1, A1:0)

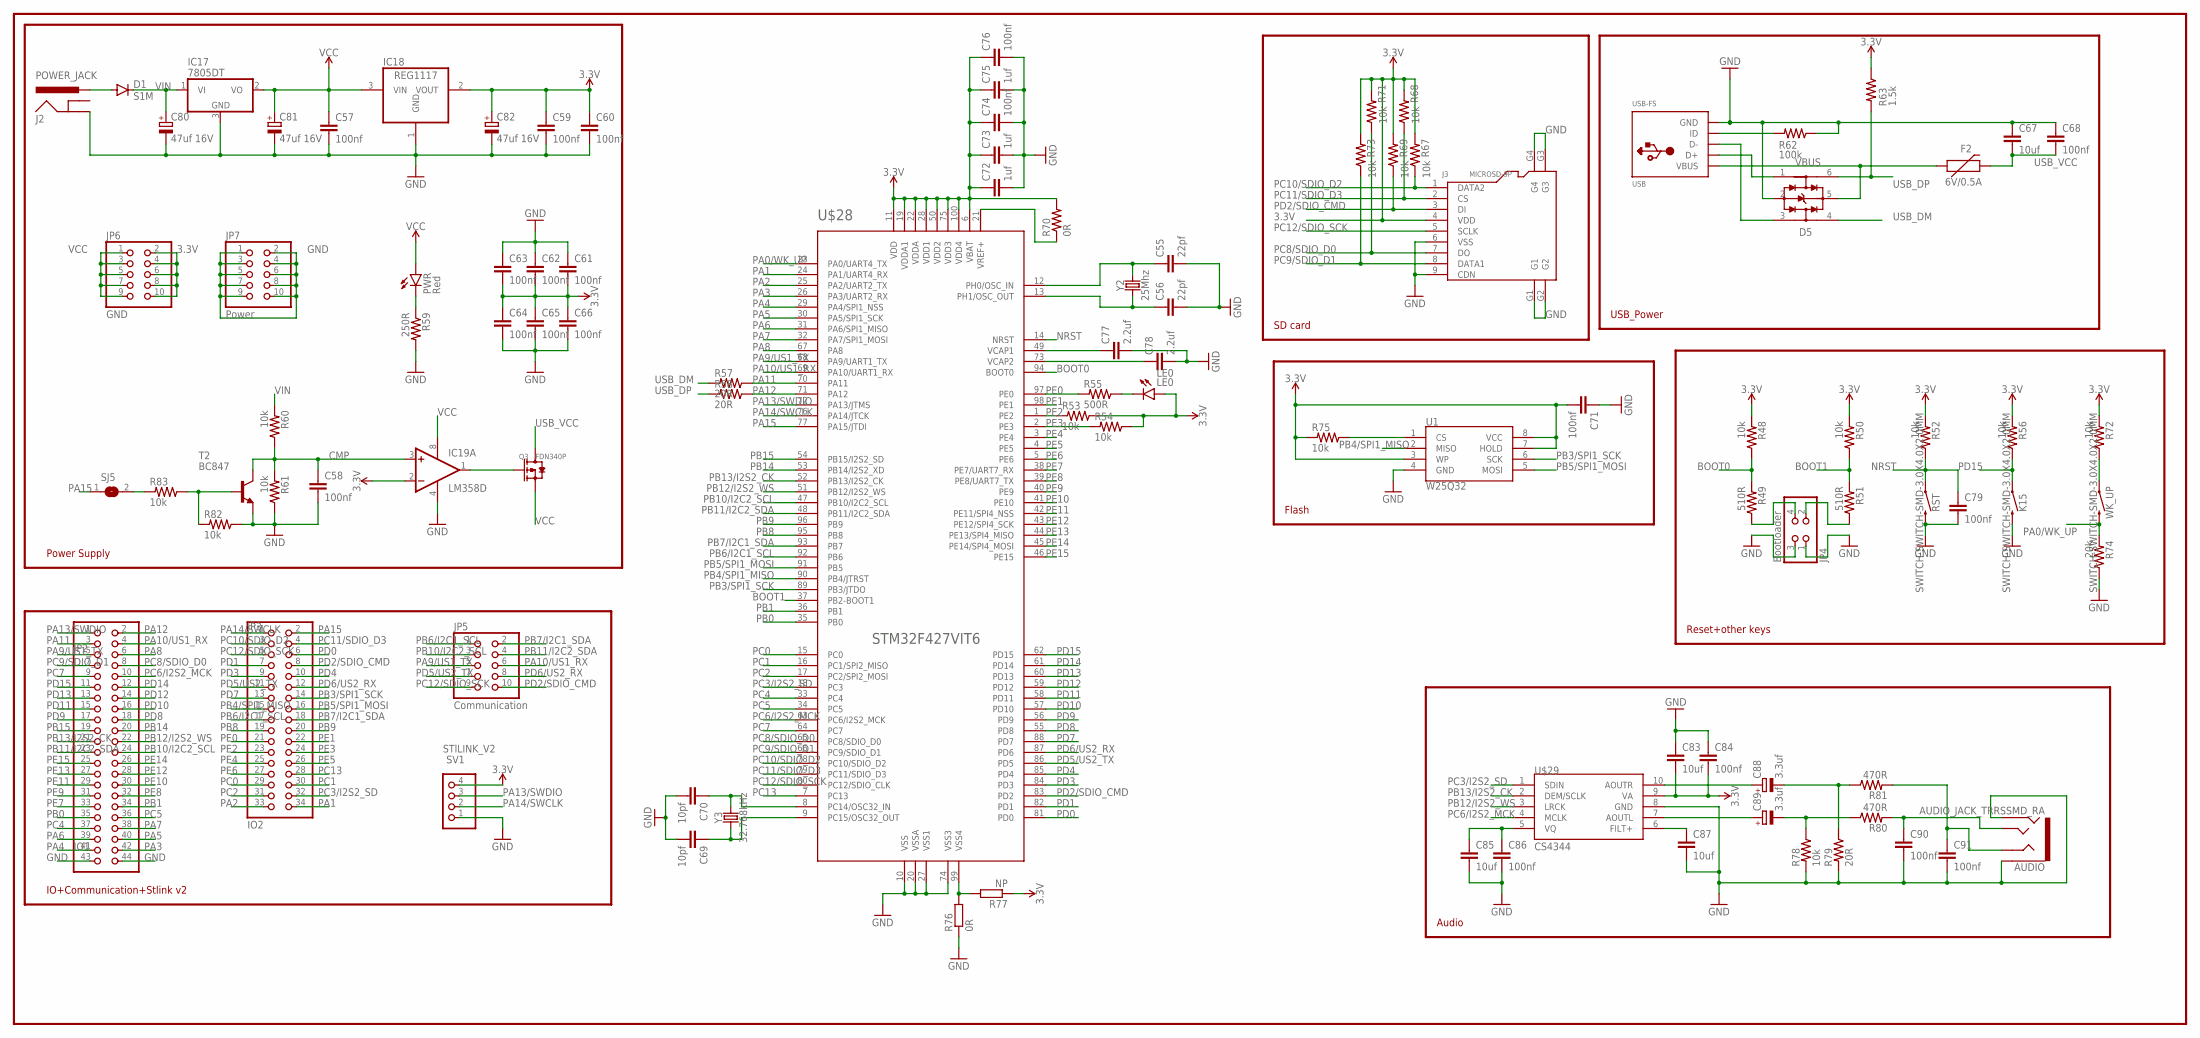
[picture p3: schematic Powersupply_RevA_discrete.sch, sheet 2]

Parts:
AUDIO: AUDIO_JACK_TRRSSMD_RA; AUDIO_JACK_3.5MM_TRRS_SMD_RA
C55, C56: 22pf; C0805
C57, C58, C59, C60, C61, C62, C63, C64, C65, C66, C68, C71, C74, C76, C79, C84, C86, C90, C91: 100nf; C0603
C67: 10uf; C0805
C69, C70: 10pf; C0805
C72, C73, C75: 1uf; C0805
C77, C78: 2.2uf; C0805
C80, C81, C82: 47uf 16V; E2-5
C83, C85, C87: 10uf; C1210
C88, C89: 3.3uf; A/3216-18R
D1: S1M; SMA
D5: USBLC6-2P; SOT23-6
F2: 6V/0.5A; 1206
IC17: 7805DT; TO252
IC18: REG1117; SOT223
IC19: LM358D; SO08
J2: POWER_JACK; POWER_JACK_PTH
J3: MICROSD-9P; MICRO-SD9+4P-SMD-16.1X14.5X1.85MM
JP2: IO1; 2X22
JP3: IO2; 2X17
JP4: Bootloader; 2X02
JP5: Communication; 2X05
JP6: GND; 2X05
JP7: Power; 2X05
K15: SWITCH-SWITCH-SMD-3.0X4.0X2.0MM; TACTILE_SWITCH_SMD_6.0X3.5MM
LE0: LE0; CHIP-LED0805
PWR: Red; CHIP-LED0805
Q3: FDN340P; SOT-23
R48, R50, R52, R53, R54, R56, R60, R61, R67, R68, R69, R71, R72, R73, R75, R78, R82, R83: 10k; R0805
R49, R51: 510R; R0805
R55: 500R; R0805
R57, R58, R79: 20R; R0805
R59: 250R; R0805
R62: 100k; R0805
R63: 1.5k; R0805
R70: 0R; R0805
R74: 20k; R0805
R76: 0R; R0402
R77: NP; R0402
R80, R81: 470R; R0805
RST: SWITCH-SWITCH-SMD-3.0X4.0X2.0MM; TACTILE_SWITCH_SMD_6.0X3.5MM
SJ5: SJ
SV1: STlLINK_V2; 1X04
T2: BC847; SOT23
U1: W25Q32; SO08
U$28: STM32F427VIT6; LQFP100
U$29: CS4344; TSSOP10
USB: USB-FS; USB-MINIB
WK_UP: SWITCH-SWITCH-SMD-3.0X4.0X2.0MM; TACTILE_SWITCH_SMD_6.0X3.5MM
Y2: 25Mhz; CRYSTAL-SMD-3.2X2.5MM
Y3: 32.768kHz; CRYSTAL-PTH-2X6-CYL

Connections:
3.3V: C59.1, C60.1, C61.2, C62.2, C63.2, C64.1, C65.1, C66.1, C71.2, C72.1, C73.1, C74.1, C75.1, C76.1, C82.+, C83.2, C84.2, IC18.2 (VOUT), IC19.2 (-IN), J3.4 (VDD), JP6.2, JP6.4, JP6.6, JP6.8, JP6.10, LE0.A, R48.2, R50.2, R52.2, R53.1, R54.1, R56.2, R63.1, R67.2, R68.2, R69.2, R70.2, R71.2, R72.2, R73.2, R75.2, R77.1, SV1.4, U1.3 (WP), U1.7 (HOLD), U1.8 (VCC), U$28.6 (VBAT), U$28.11 (VDD), U$28.19 (VDDA1), U$28.22 (VDDA), U$28.28 (VDD1), U$28.50 (VDD2), U$28.75 (VDD3), U$28.100 (VDD4), U$29.9 (VA)
BOOT0: R48.1, R49.2, U$28.94 (BOOT0)
BOOT1: R50.1, R51.2, U$28.37 (PB2-BOOT1)
CMP: C58.1, IC19.3 (+IN), R60.1, R61.2, T2.3 (C)
GND: AUDIO.EARTH, AUDIO.RING2, C55.2, C56.2, C57.2, C58.2, C59.2, C60.2, C61.1, C62.1, C63.1, C64.2, C65.2, C66.2, C67.1, C68.1, C69.2, C70.2, C71.1, C72.2, C73.2, C74.2, C75.2, C76.2, C77.2, C78.2, C79.2, C80.-, C81.-, C82.-, C83.1, C84.1, C85.2, C86.2, C87.2, C90.2, C91.2, D5.2 (GND), IC17.3 (GND), IC18.1 (GND), IC19.4 (V-), J2.GND, J3.6 (VSS), J3.9 (CDN), J3.G1, J3.G2, J3.G3, J3.G4, JP2.43, JP2.44, JP4.1, JP4.3, JP7.1, JP7.2, JP7.3, JP7.4, JP7.5, JP7.6, JP7.7, JP7.8, JP7.9, JP7.10, K15.2, R59.2, R61.1, R62.1, R74.1, R76.1, R78.2, R79.2, R82.1, RST.2, SV1.1, T2.2 (E), U1.4 (GND), U$28.10 (VSS), U$28.20 (VSSA), U$28.27 (VSS1), U$28.74 (VSS3), U$29.8 (GND), USB.GND; also elsewhere on the board
unnamed: C55.1, U$28.12 (PH0/OSC_IN), Y2.3 (2)
unnamed: C56.1, U$28.13 (PH1/OSC_OUT), Y2.1
unnamed: IC19.1 (OUT), Q3.1 (G)
unnamed: C69.1, U$28.9 (PC15/OSC32_OUT), Y3.1
unnamed: C70.1, U$28.8 (PC14/OSC32_IN), Y3.2
unnamed: R62.2, USB.ID
unnamed: LE0.C, R55.1
unnamed: D1.A, J2.PWR
unnamed: C77.1, U$28.49 (VCAP1)
unnamed: C78.1, U$28.73 (VCAP2)
unnamed: PWR.C, R59.1
unnamed: D5.1 (I/O1-IN), USB.D+
unnamed: JP4.4, R49.1
unnamed: JP4.2, R51.1
unnamed: R82.2, R83.1, T2.1 (B)
unnamed: R83.2, SJ5.2
unnamed: R70.1, U$28.21 (VREF+)
unnamed: R72.1, WK_UP.1
unnamed: R75.1, U1.1 (CS)
unnamed: D5.3 (I/O2-IN), USB.D-
unnamed: R76.2, R77.2, U$28.99 (VSS4)
unnamed: C87.1, U$29.6 (FILT+)
unnamed: C85.1, C86.1, U$29.5 (VQ)
unnamed: C88.+, U$29.10 (AOUTR)
unnamed: C89.+, U$29.7 (AOUTL)
unnamed: C89.-, R78.1, R80.1
unnamed: C88.-, R79.1, R81.1
unnamed: AUDIO.TIP, C90.1, R80.2
unnamed: AUDIO.RING1, C91.1, R81.2
NRST: C79.1, R52.1, RST.1, U$28.14 (NRST)
PA0/WK_UP: R74.2, U$28.23 (PA0/UART4_TX), WK_UP.2
PA1: JP3.34, U$28.24 (PA1/UART4_RX)
PA2: JP3.33, U$28.25 (PA2/UART2_TX)
PA3: JP2.42, U$28.26 (PA3/UART2_RX)
PA4: JP2.41, U$28.29 (PA4/SPI1_NSS)
PA5: JP2.40, U$28.30 (PA5/SPI1_SCK)
PA6: JP2.39, U$28.31 (PA6/SPI1_MISO)
PA7: JP2.38, U$28.32 (PA7/SPI1_MOSI)
PA8: JP2.6, U$28.67 (PA8)
PA9/US1_TX: JP2.5, JP5.5, U$28.68 (PA9/UART1_TX)
PA10/US1_RX: JP2.4, JP5.6, U$28.69 (PA10/UART1_RX)
PA11: JP2.3, R57.1, U$28.70 (PA11)
PA12: JP2.2, R58.1, U$28.71 (PA12)
PA13/SWDIO: JP2.1, SV1.3, U$28.72 (PA13/JTMS)
PA14/SWCLK: JP3.1, SV1.2, U$28.76 (PA14/JTCK)
PA15: JP3.2, SJ5.1, U$28.77 (PA15/JTDI)
PB0: JP2.35, U$28.35 (PB0)
PB1: JP2.34, U$28.36 (PB1)
PB3/SPI1_SCK: JP3.14, U1.6 (SCK), U$28.89 (PB3/JTDO)
PB4/SPI1_MISO: JP3.15, U1.2 (MISO), U$28.90 (PB4/JTRST)
PB5/SPI1_MOSI: JP3.16, U1.5 (MOSI), U$28.91 (PB5)
PB6/I2C1_SCL: JP3.17, JP5.1, U$28.92 (PB6)
PB7/I2C1_SDA: JP3.18, JP5.2, U$28.93 (PB7)
PB8: JP3.19, U$28.95 (PB8)
PB9: JP3.20, U$28.96 (PB9)
PB10/I2C2_SCL: JP2.24, JP5.3, U$28.47 (PB10/I2C2_SCL)
PB11/I2C2_SDA: JP2.23, JP5.4, U$28.48 (PB11/I2C2_SDA)
PB12/I2S2_WS: JP2.22, U$28.51 (PB12/I2S2_WS), U$29.3 (LRCK)
PB13/I2S2_CK: JP2.21, U$28.52 (PB13/I2S2_CK), U$29.2 (DEM/SCLK)
PB14: JP2.20, U$28.53 (PB14/I2S2_XD)
PB15: JP2.19, U$28.54 (PB15/I2S2_SD)
PC0: JP3.29, U$28.15 (PC0)
PC1: JP3.30, U$28.16 (PC1/SPI2_MISO)
PC2: JP3.31, U$28.17 (PC2/SPI2_MOSI)
PC3/I2S2_SD: JP3.32, U$28.18 (PC3), U$29.1 (SDIN)
PC4: JP2.37, U$28.33 (PC4)
PC5: JP2.36, U$28.34 (PC5)
PC6/I2S2_MCK: JP2.10, U$28.63 (PC6/I2S2_MCK), U$29.4 (MCLK)
PC7: JP2.9, U$28.64 (PC7)
PC8/SDIO_D0: J3.7 (DO), JP2.8, R71.1, U$28.65 (PC8/SDIO_D0)
PC9/SDIO_D1: J3.8 (DATA1), JP2.7, R73.1, U$28.66 (PC9/SDIO_D1)
PC10/SDIO_D2: J3.1 (DATA2), JP3.3, R67.1, U$28.78 (PC10/SDIO_D2)
PC11/SDIO_D3: J3.2 (CS), JP3.4, R68.1, U$28.79 (PC11/SDIO_D3)
PC12/SDIO_SCK: J3.5 (SCLK), JP3.5, JP5.9, U$28.80 (PC12/SDIO_CLK)
PC13: JP3.28, U$28.7 (PC13)
PD0: JP3.6, U$28.81 (PD0)
PD1: JP3.7, U$28.82 (PD1)
PD2/SDIO_CMD: J3.3 (DI), JP3.8, JP5.10, R69.1, U$28.83 (PD2)
PD3: JP3.9, U$28.84 (PD3)
PD4: JP3.10, U$28.85 (PD4)
PD5/US2_TX: JP3.11, JP5.7, U$28.86 (PD5)
PD6/US2_RX: JP3.12, JP5.8, U$28.87 (PD6)
PD7: JP3.13, U$28.88 (PD7)
PD8: JP2.18, U$28.55 (PD8)
PD9: JP2.17, U$28.56 (PD9)
PD10: JP2.16, U$28.57 (PD10)
PD11: JP2.15, U$28.58 (PD11)
PD12: JP2.14, U$28.59 (PD12)
PD13: JP2.13, U$28.60 (PD13)
PD14: JP2.12, U$28.61 (PD14)
PD15: JP2.11, K15.1, R56.1, U$28.62 (PD15)
PE0: JP3.21, R55.2, U$28.97 (PE0)
PE1: JP3.22, U$28.98 (PE1)
PE2: JP3.23, R53.2, U$28.1 (PE2)
PE3: JP3.24, R54.2, U$28.2 (PE3)
PE4: JP3.25, U$28.3 (PE4)
PE5: JP3.26, U$28.4 (PE5)
PE6: JP3.27, U$28.5 (PE6)
PE7: JP2.33, U$28.38 (PE7/UART7_RX)
PE8: JP2.32, U$28.39 (PE8/UART7_TX)
PE9: JP2.31, U$28.40 (PE9)
PE10: JP2.30, U$28.41 (PE10)
PE11: JP2.29, U$28.42 (PE11/SPI4_NSS)
PE12: JP2.28, U$28.43 (PE12/SPI4_SCK)
PE13: JP2.27, U$28.44 (PE13/SPI4_MISO)
PE14: JP2.26, U$28.45 (PE14/SPI4_MOSI)
PE15: JP2.25, U$28.46 (PE15)
USB_DM: D5.4 (I/O2-OUT), R57.2
USB_DP: D5.6 (I/O1-OUT), R58.2, R63.2
USB_VCC: C67.2, C68.2, F2.2, Q3.3 (D)
VBUS: D5.5 (VBUS), F2.1, USB.VBUS
VCC: C57.1, C81.+, IC17.2 (VO), IC18.3 (VIN), IC19.8 (V+), JP6.1, JP6.3, JP6.5, JP6.7, JP6.9, PWR.A, Q3.2 (S)
VIN: C80.+, D1.C, IC17.1 (VI), R60.2

Notes on the sheet:
Power Supply
IO+Communication+Stlink v2
SD card
Flash
USB_Power
Reset+other keys
Audio

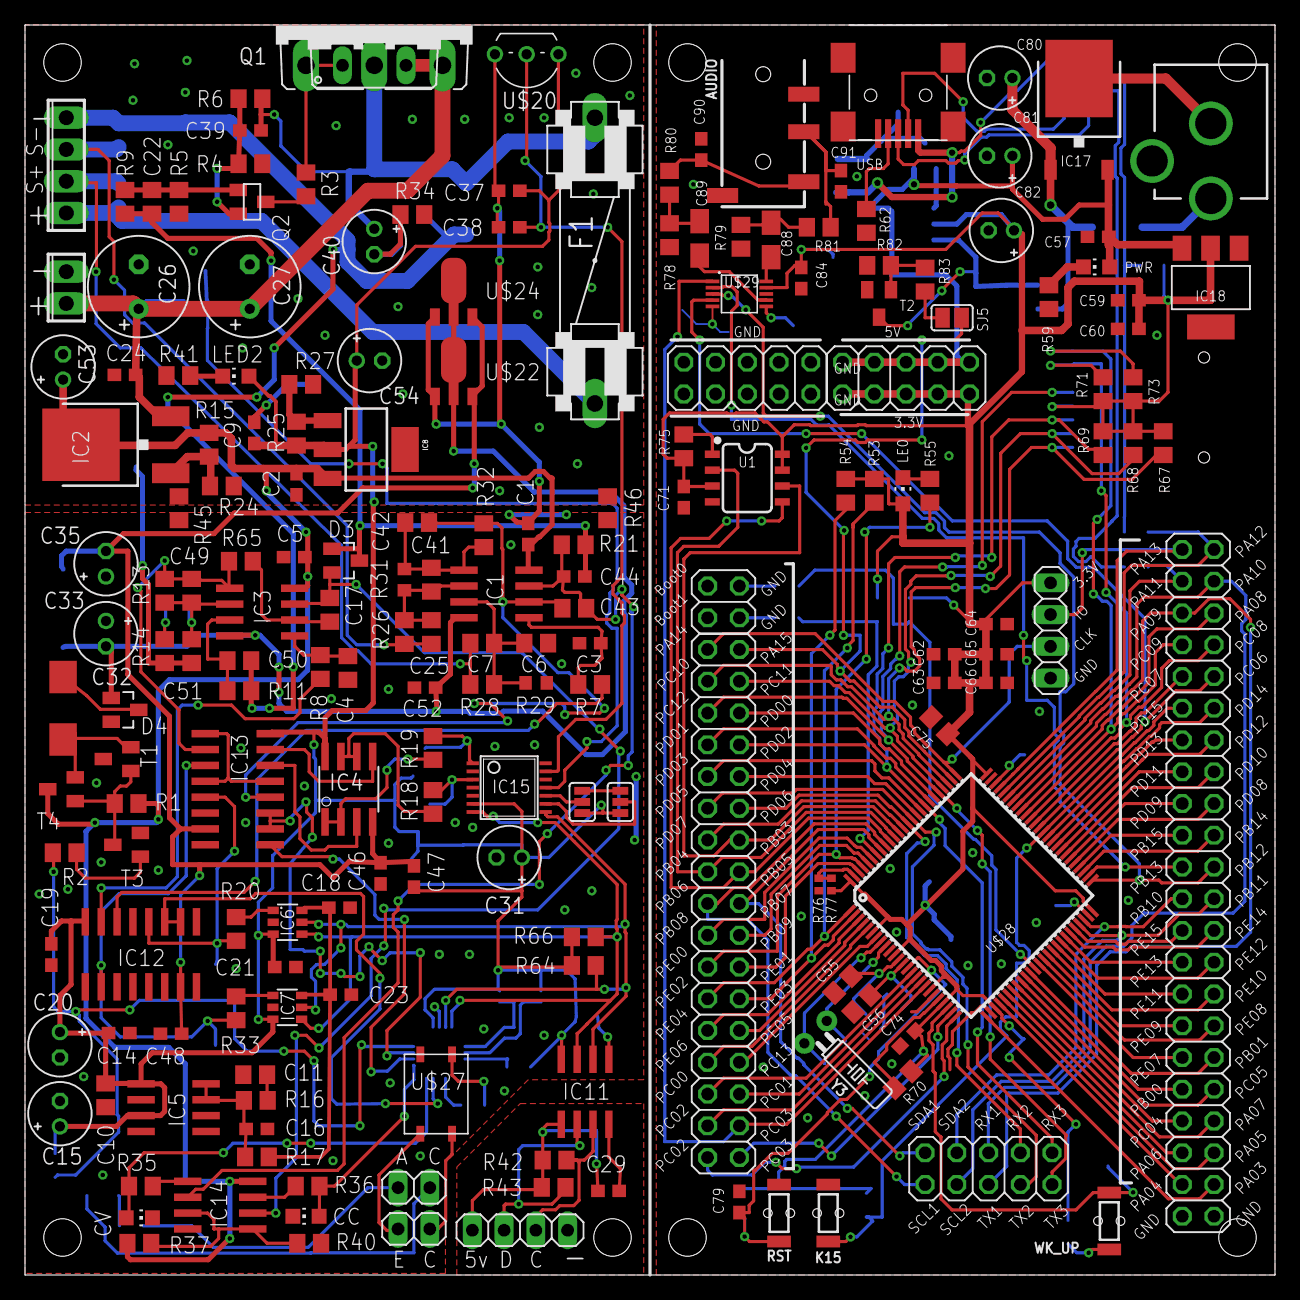
[picture p4: board Powersupply_RevA_discrete.brd from above]

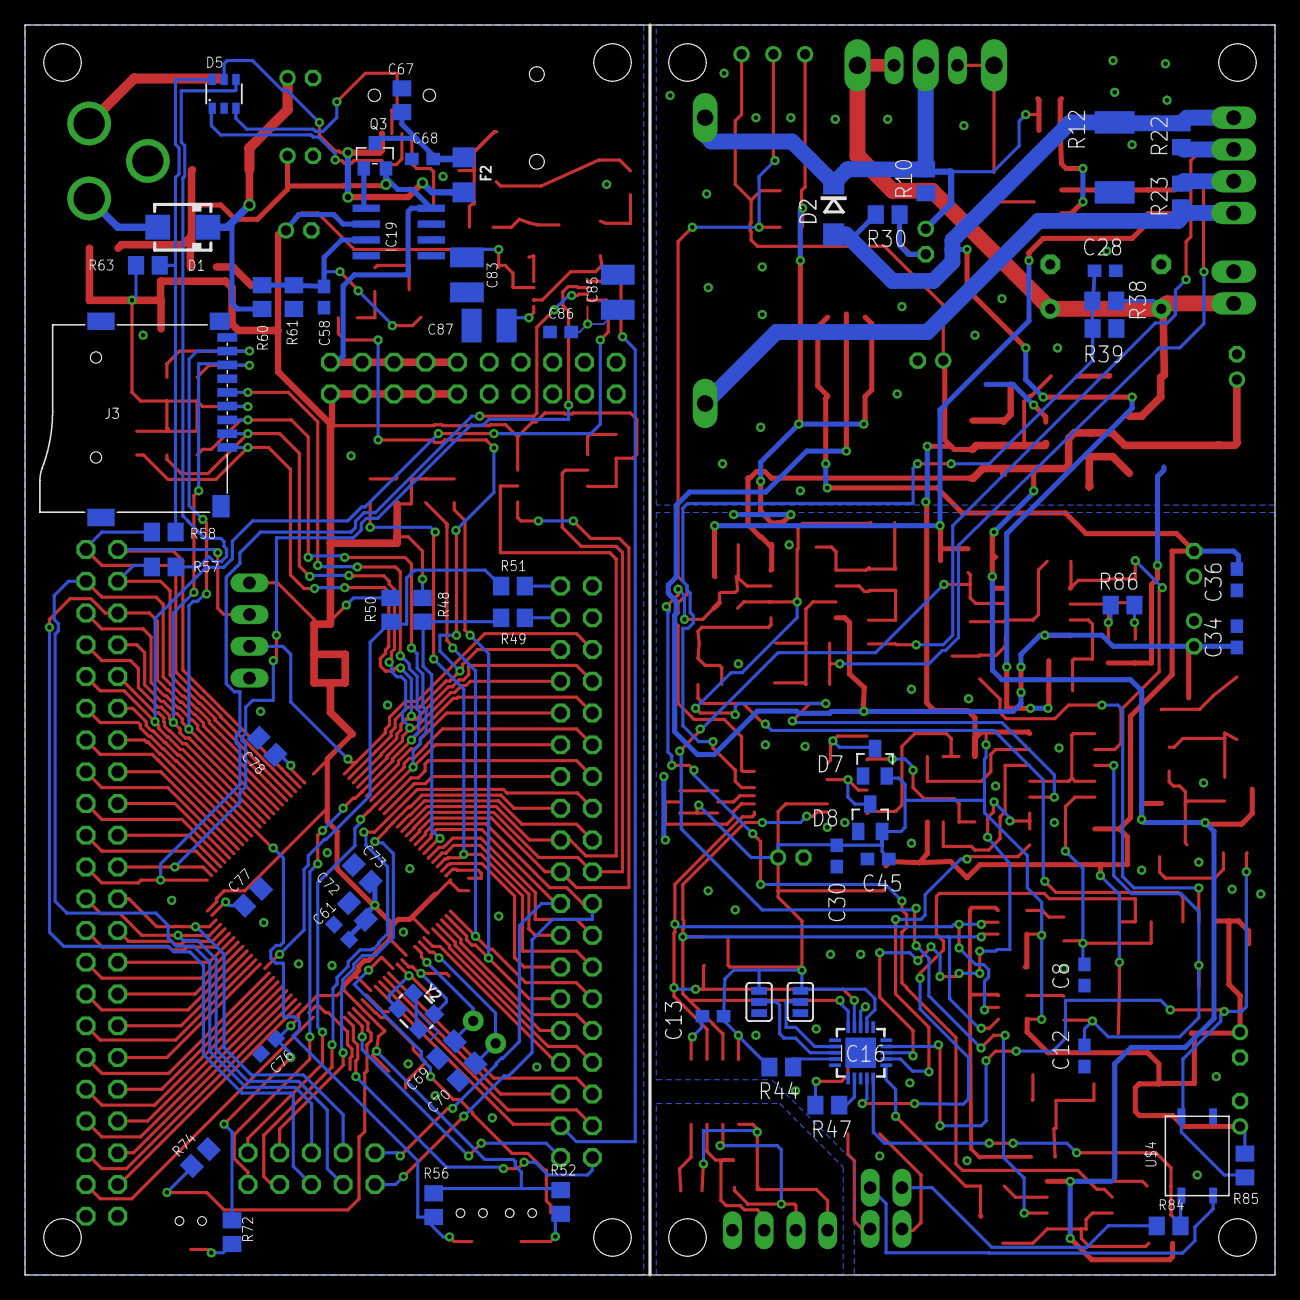
[picture p5: board Powersupply_RevA_discrete.brd from below]

Board: 2 copper layers, 100.0 x 100.0 mm, 250 parts (62 on the bottom side), 200 nets.
