lgv2018/Power-Supply/(commit log)

2019-05-24 commited power supply project
2019-05-26 Added calibration
2019-05-26 change of buttons
2019-05-27 Two point calibration added
2019-05-29 Calibration saving to EEPROM feature added
2019-08-23 calibration menu improvement
2019-09-19 added other documents
    [PowerSupply-Om.xlsx, PowerSupply.xlsx, Powersupply_RevA_discrete.brd, Powersupply_RevA_discrete.sch]
